balmerdx/BalmerDX_VNA/doc/wiki_img/history/vna_v1.JPG

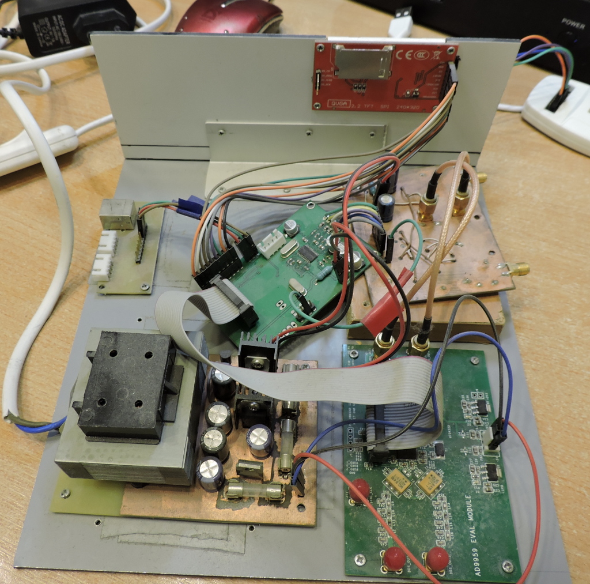
doc/wiki_img/history/vna_v1.JPG
