balmerdx/BalmerDX_VNA/doc/wiki_img/device/calibraion_menu.JPG

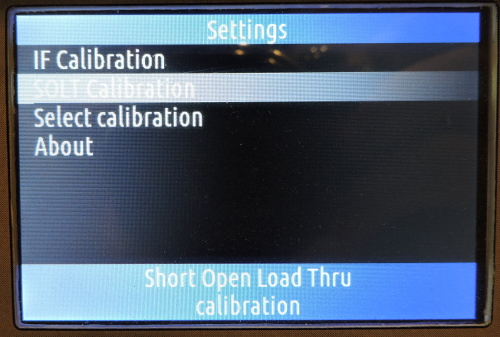
doc/wiki_img/device/calibraion_menu.JPG
