balmerdx/BalmerDX_VNA/README.md

# BalmerDX_VNA
Vector Network Analyzer 10 KHz - 180 MHz

[See Wiki documentation for details](https://github.com/balmerdx/BalmerDX_VNA/wiki)
