balmerdx/BalmerDX_VNA/info_stable.txt

- IDC-8 самый короткий шлейф с аналоговым сигналом 8 см
- IDC-8 шлейф на AD9958 пусть будет 10 см
- IDC-10 шлейф на энкодеры 15 см

- из модуля Step-Down MP1584 выпаиваем переменный резистор,
  и запаиваем резистор 27 КОм на специально предусмотренное для этого место
  на выходе будет 3.4 V

 - сначала сделать IF Calibration
 	определяет тоно частоту промежуточной частоты которая должна быть 1000 Гц

 - SOLT calibration
 	Все калибровки делаются с щупами, с которыми будут происходить измерения. Цупы должны быть коаксиальным кабелем с волновым сопротивлением 50 Ом.
 	s - short Нужно закоротить накоротко RX выход.
 	o - open Оставить RX выход открытым.
 	l - load
 	t - through
