balmerdx/BalmerDX_VNA/circuit_kicad/info/HTB1NCwRLpXXXXaKaXXXq6xXFXXXn.jpg

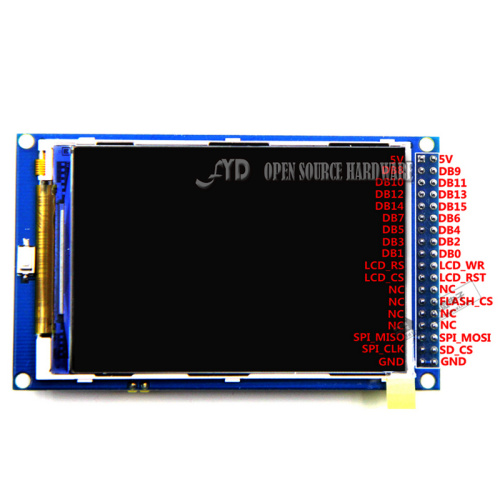
circuit_kicad/info/HTB1NCwRLpXXXXaKaXXXq6xXFXXXn.jpg
