balmerdx/BalmerDX_VNA/circuit_kicad/info/HTB1714cLFXXXXc.XpXXq6xXFXXXj.jpg

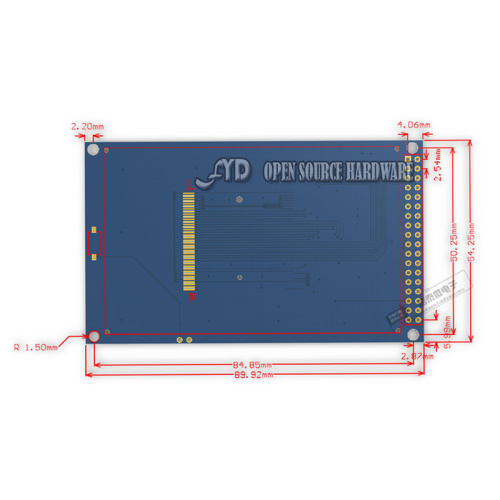
circuit_kicad/info/HTB1714cLFXXXXc.XpXXq6xXFXXXj.jpg
