balmerdx/BalmerDX_VNA/circuit_kicad/info/SG053-SZ(mil).jpg

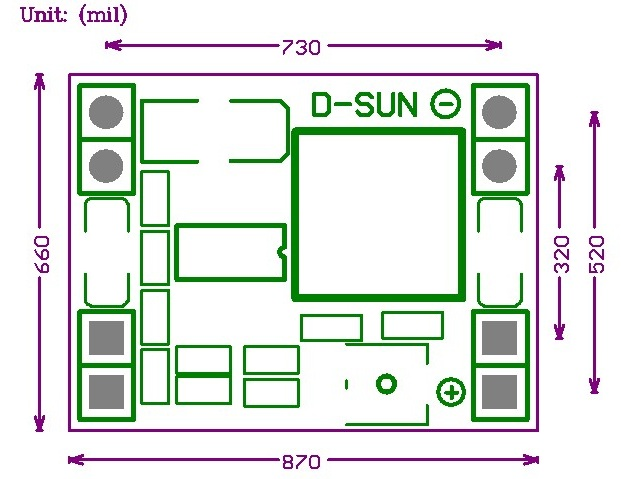
circuit_kicad/info/SG053-SZ(mil).jpg
