balmerdx/BalmerDX_VNA/circuit_kicad/info/SG053-SZ(mm).jpg

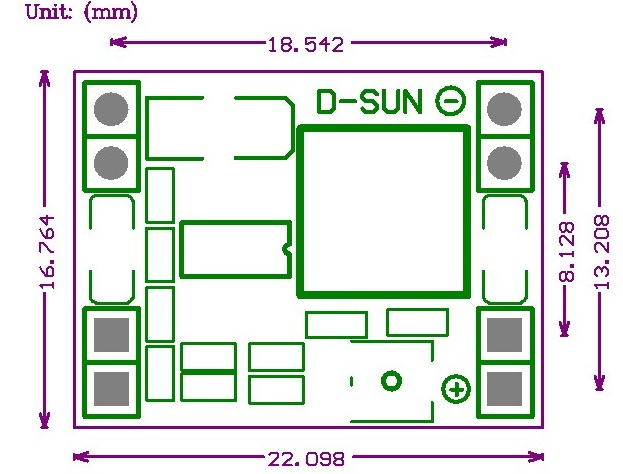
circuit_kicad/info/SG053-SZ(mm).jpg
