balmerdx/BalmerDX_VNA/doc/wiki_img/device/graph.JPG

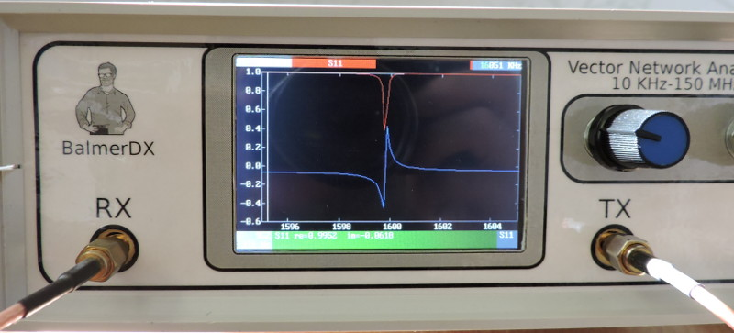
doc/wiki_img/device/graph.JPG
