balmerdx/BalmerDX_VNA/doc/wiki_img/device/main_menu.JPG

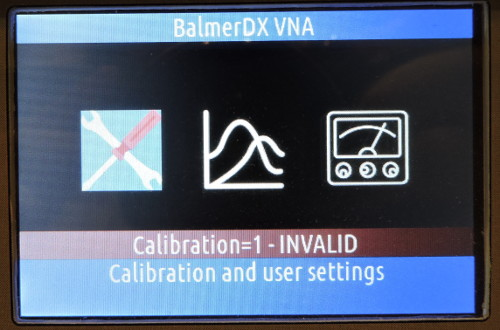
doc/wiki_img/device/main_menu.JPG
