balmerdx/BalmerDX_VNA/doc/wiki_img/device/single_freq.JPG

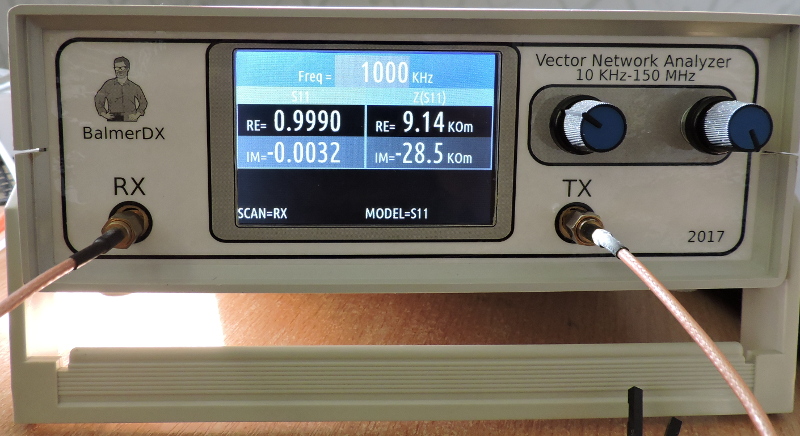
doc/wiki_img/device/single_freq.JPG
