balmerdx/BalmerDX_VNA/doc/wiki_img/frontend/filter10_24MHz_dB(S21).png

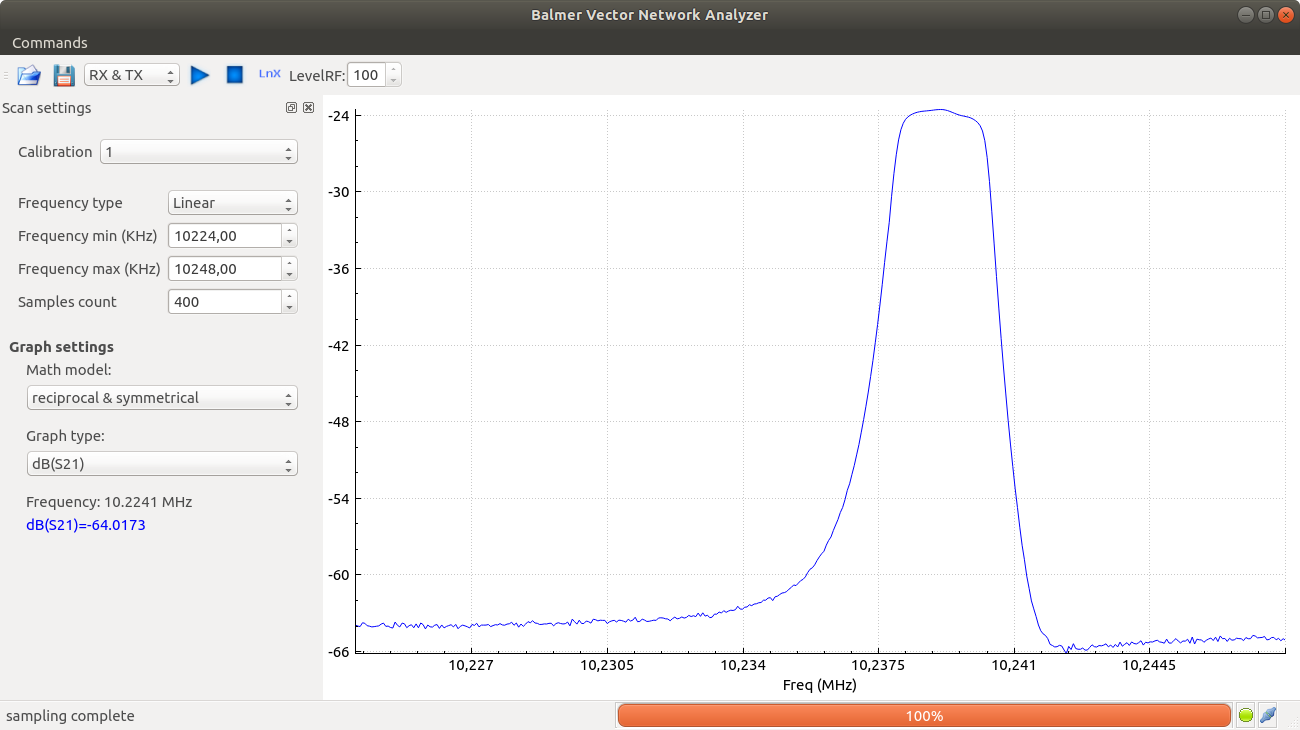
doc/wiki_img/frontend/filter10_24MHz_dB(S21).png
