balmerdx/BalmerDX_VNA/doc/wiki_img/frontend/filter10_24MHz_S21.png

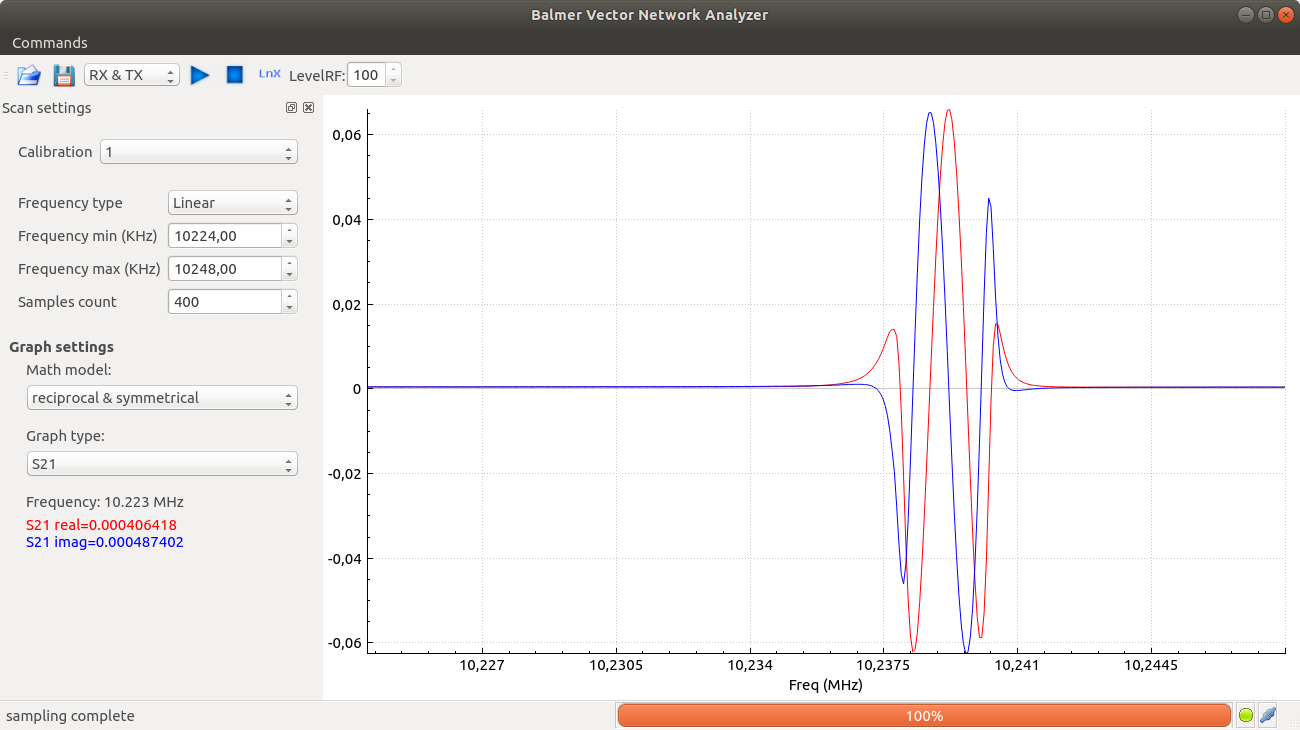
doc/wiki_img/frontend/filter10_24MHz_S21.png
