balmerdx/BalmerDX_VNA/doc/wiki_img/frontend/inductance_100uH_S11.png

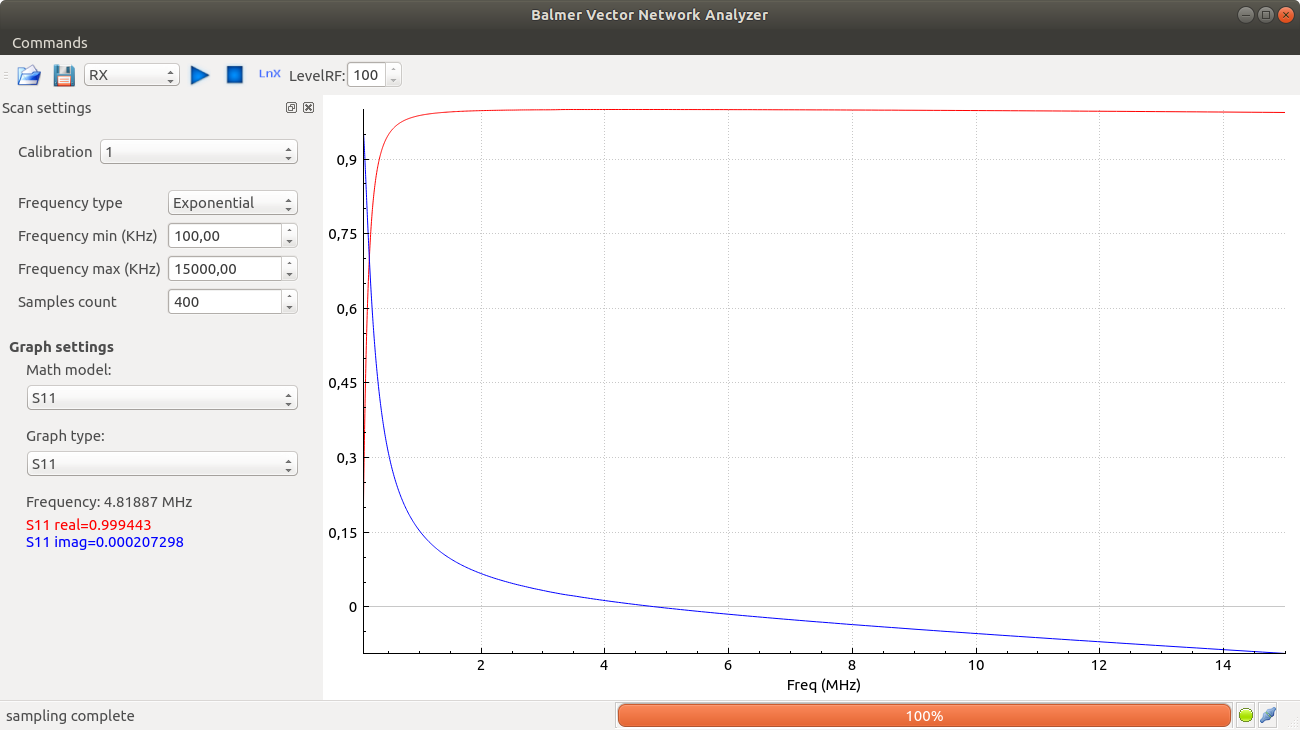
doc/wiki_img/frontend/inductance_100uH_S11.png
