balmerdx/BalmerDX_VNA/doc/wiki_img/frontend/inductance_100uH_Z(S11).png

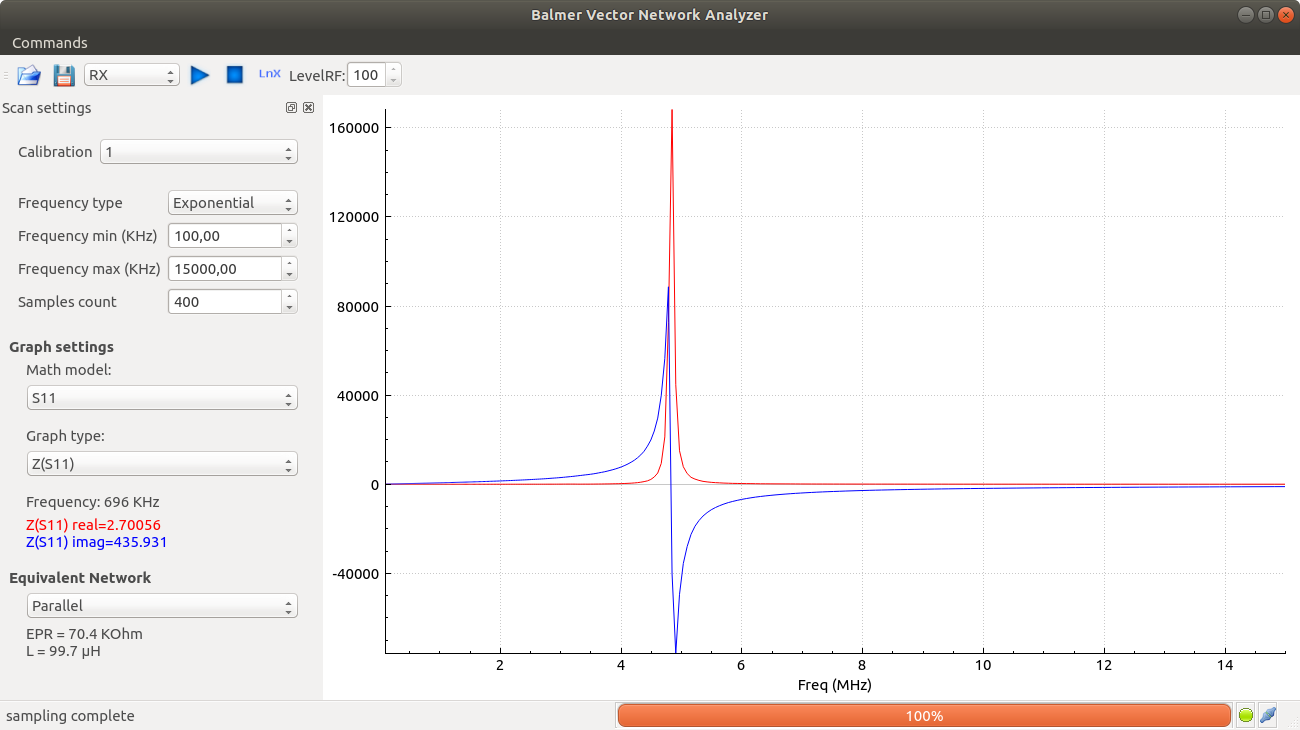
doc/wiki_img/frontend/inductance_100uH_Z(S11).png
