balmerdx/BalmerDX_VNA/doc/wiki_img/frontend/quartz16mhz_S21.png

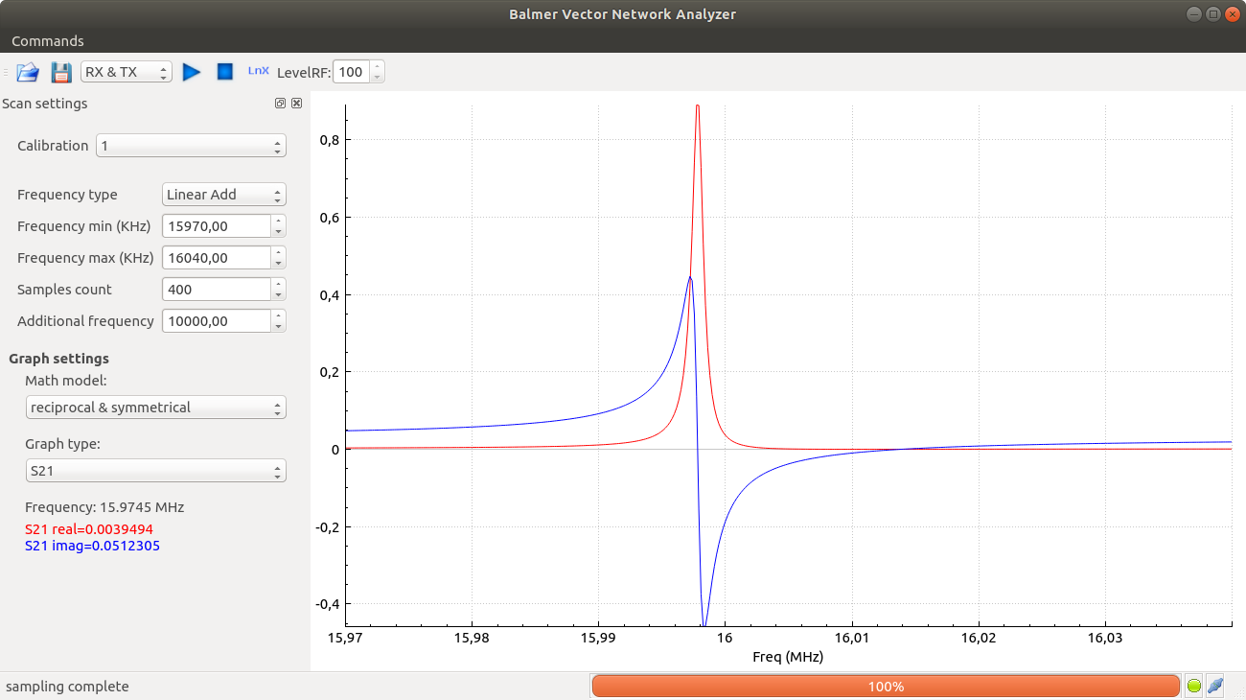
doc/wiki_img/frontend/quartz16mhz_S21.png
