balmerdx/BalmerDX_VNA/doc/wiki_img/home/vna_front.JPG

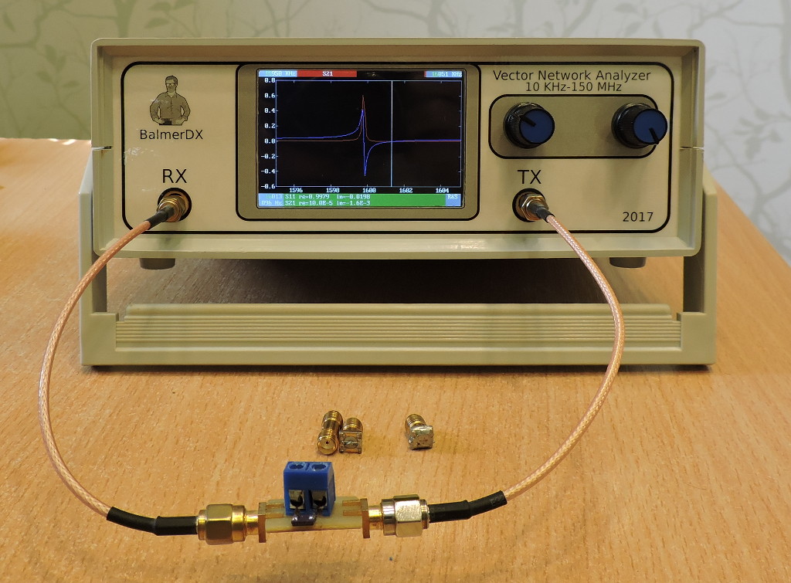
doc/wiki_img/home/vna_front.JPG
