balmerdx/BalmerDX_VNA/doc/wiki_img/misc/MP1584.JPG

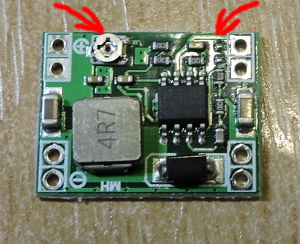
doc/wiki_img/misc/MP1584.JPG
