balmerdx/BalmerDX_VNA/doc/wiki_img/schematic/board_sch1_back.JPG

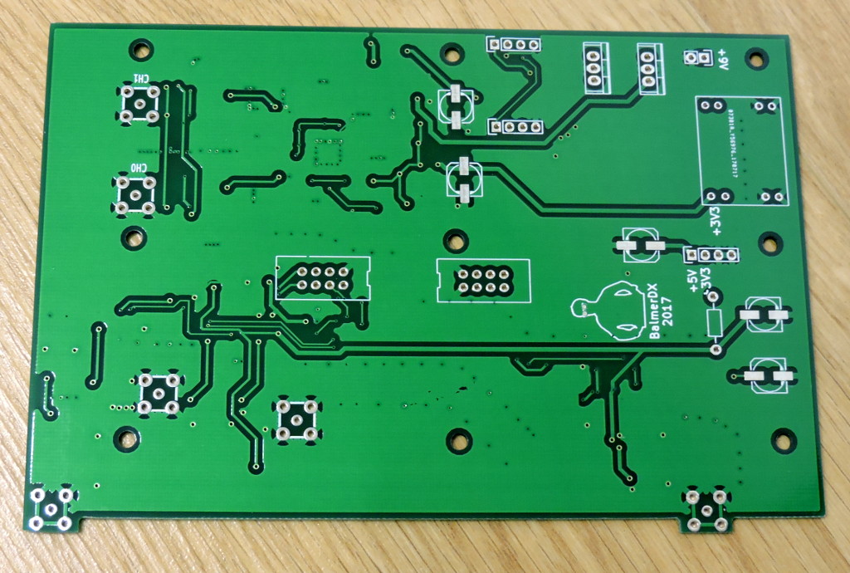
doc/wiki_img/schematic/board_sch1_back.JPG
