balmerdx/BalmerDX_VNA/doc/wiki_img/schematic/board_sch1_front.JPG

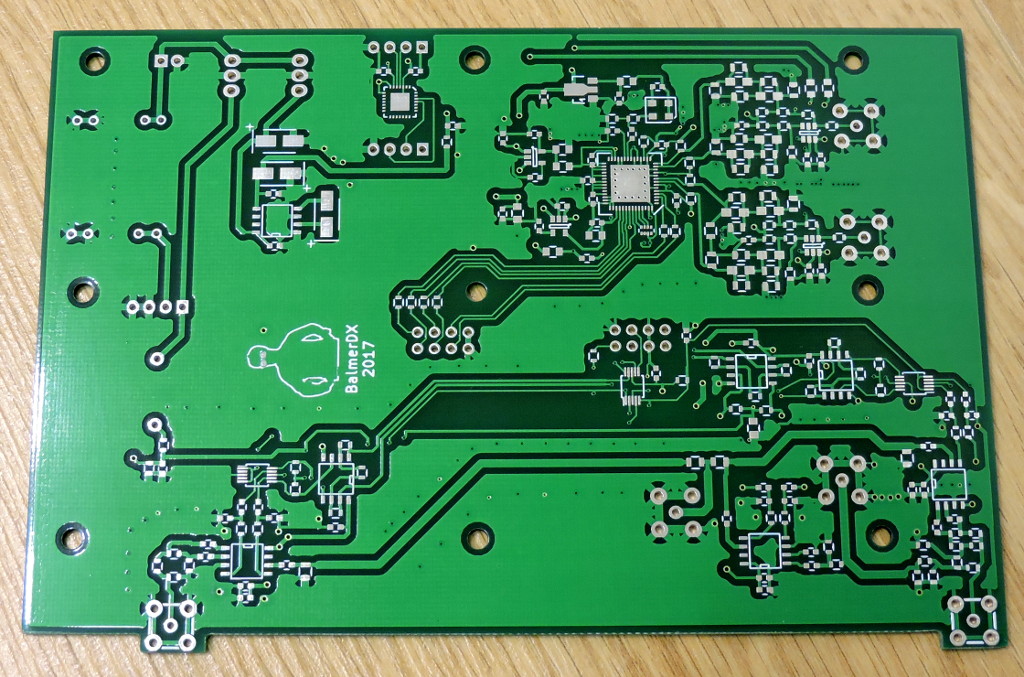
doc/wiki_img/schematic/board_sch1_front.JPG
