balmerdx/BalmerDX_VNA/doc/wiki_img/schematic/board_sch2_and_sch3.JPG

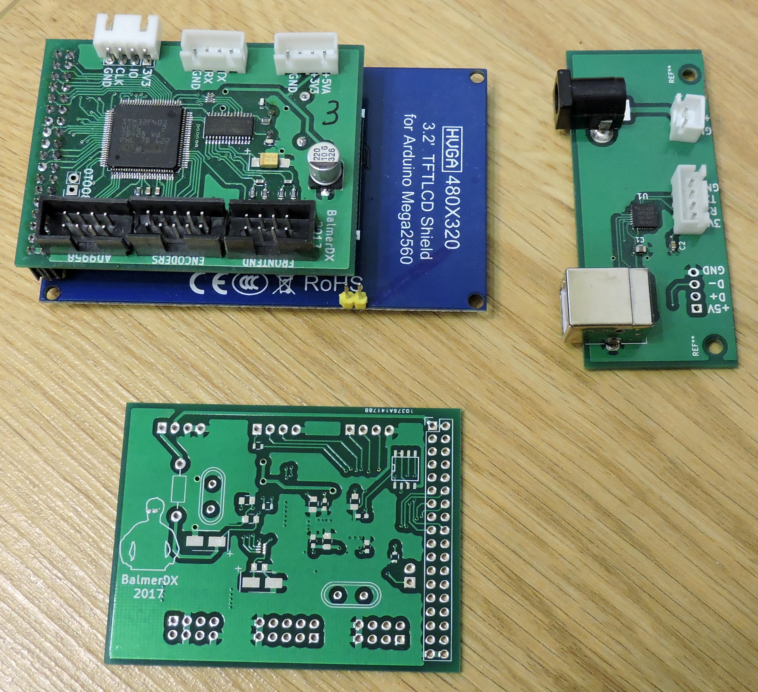
doc/wiki_img/schematic/board_sch2_and_sch3.JPG
