balmerdx/BalmerDX_VNA/doc/wiki_img/schematic/sch1_ad9958.png

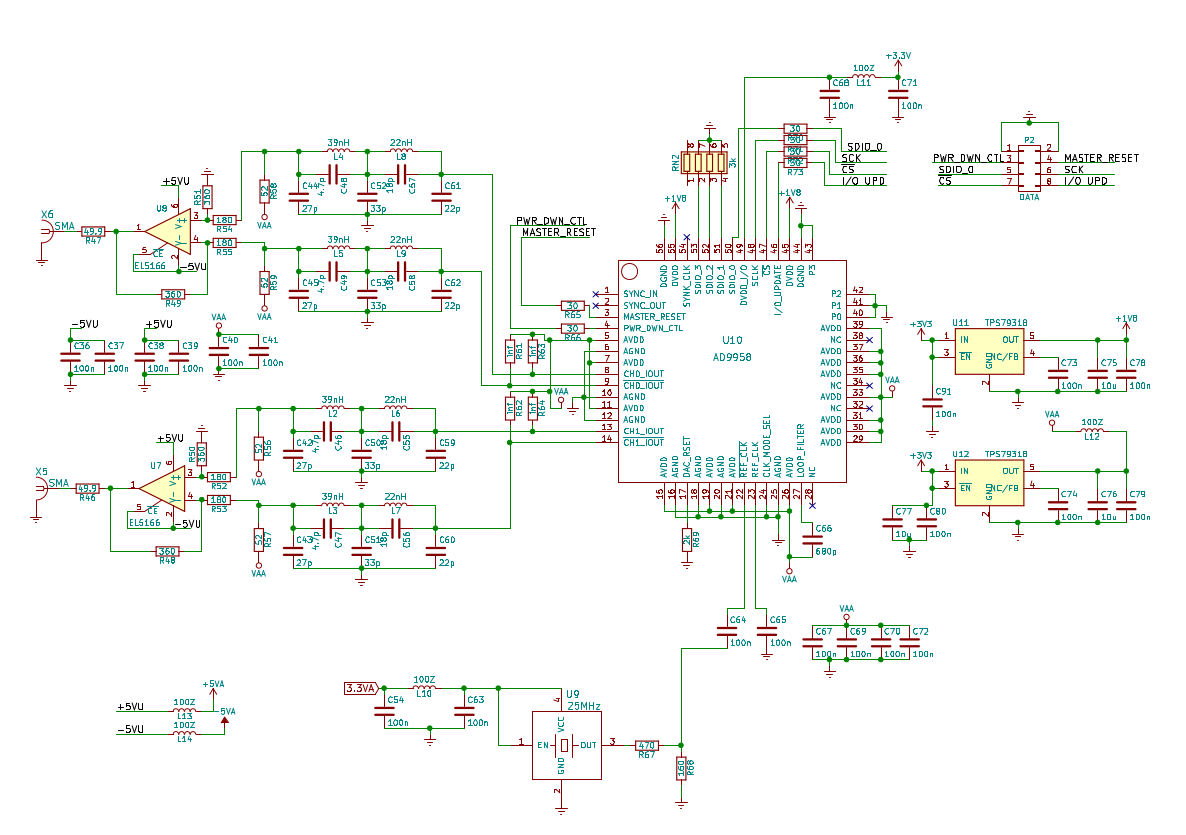
doc/wiki_img/schematic/sch1_ad9958.png
