balmerdx/BalmerDX_VNA/doc/wiki_img/schematic/sch1_analog.png

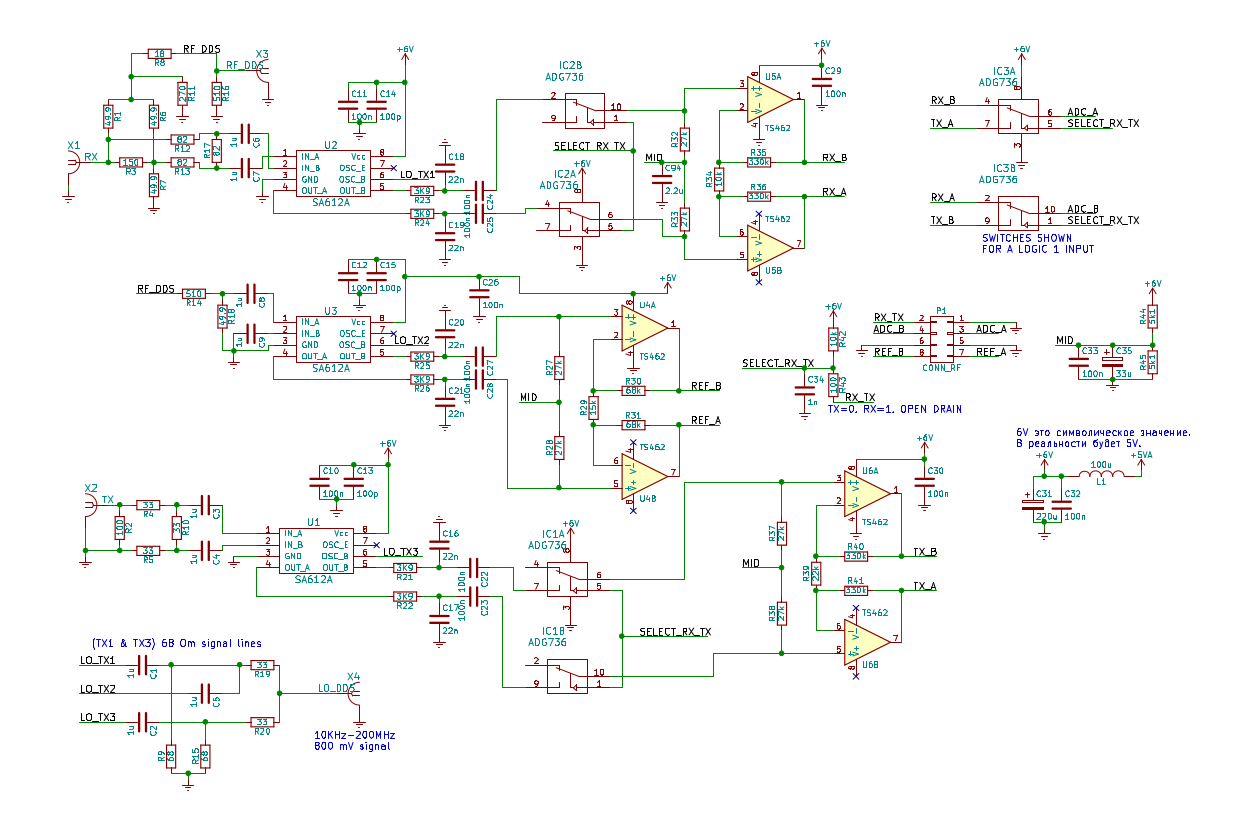
doc/wiki_img/schematic/sch1_analog.png
