balmerdx/BalmerDX_VNA/doc/wiki_img/schematic/sch1_analog_power.png

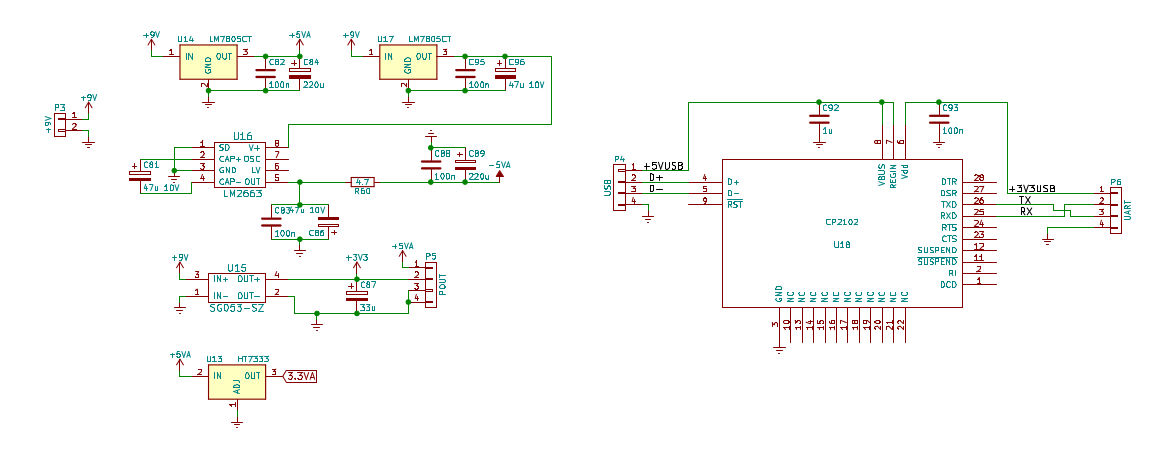
doc/wiki_img/schematic/sch1_analog_power.png
