balmerdx/BalmerDX_VNA/doc/wiki_img/schematic/sch2_cs4272.png

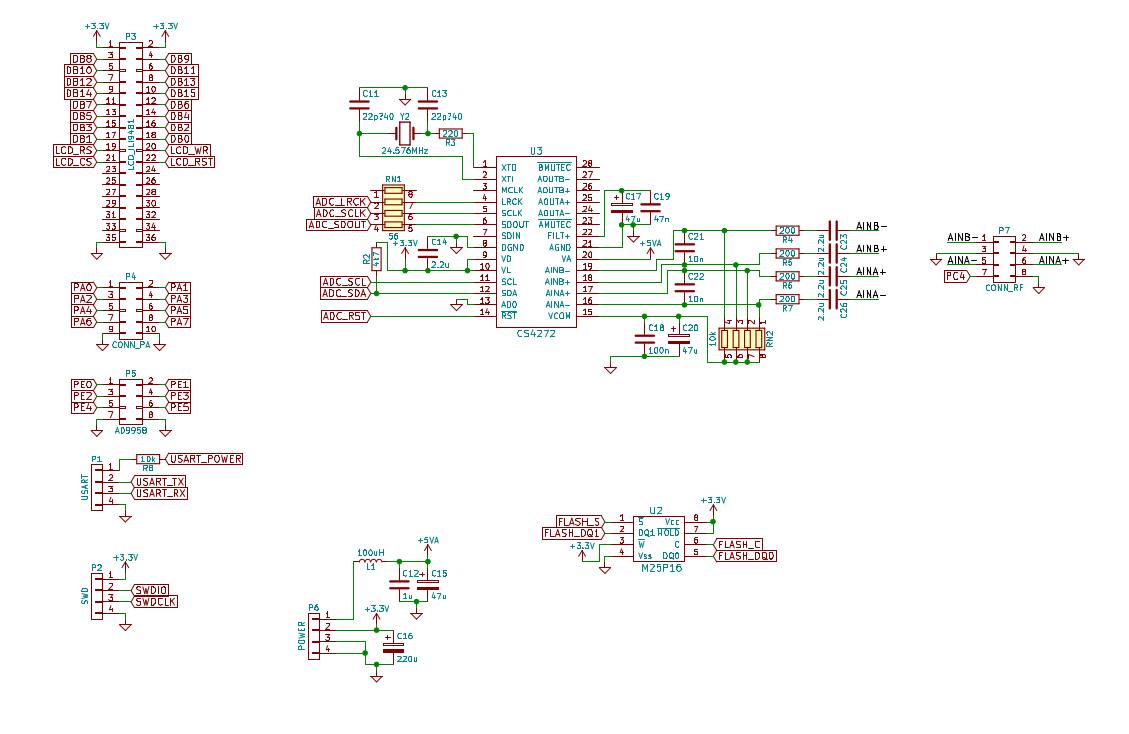
doc/wiki_img/schematic/sch2_cs4272.png
