balmerdx/BalmerDX_VNA/doc/wiki_img/schematic/sch2_STM32F405.png

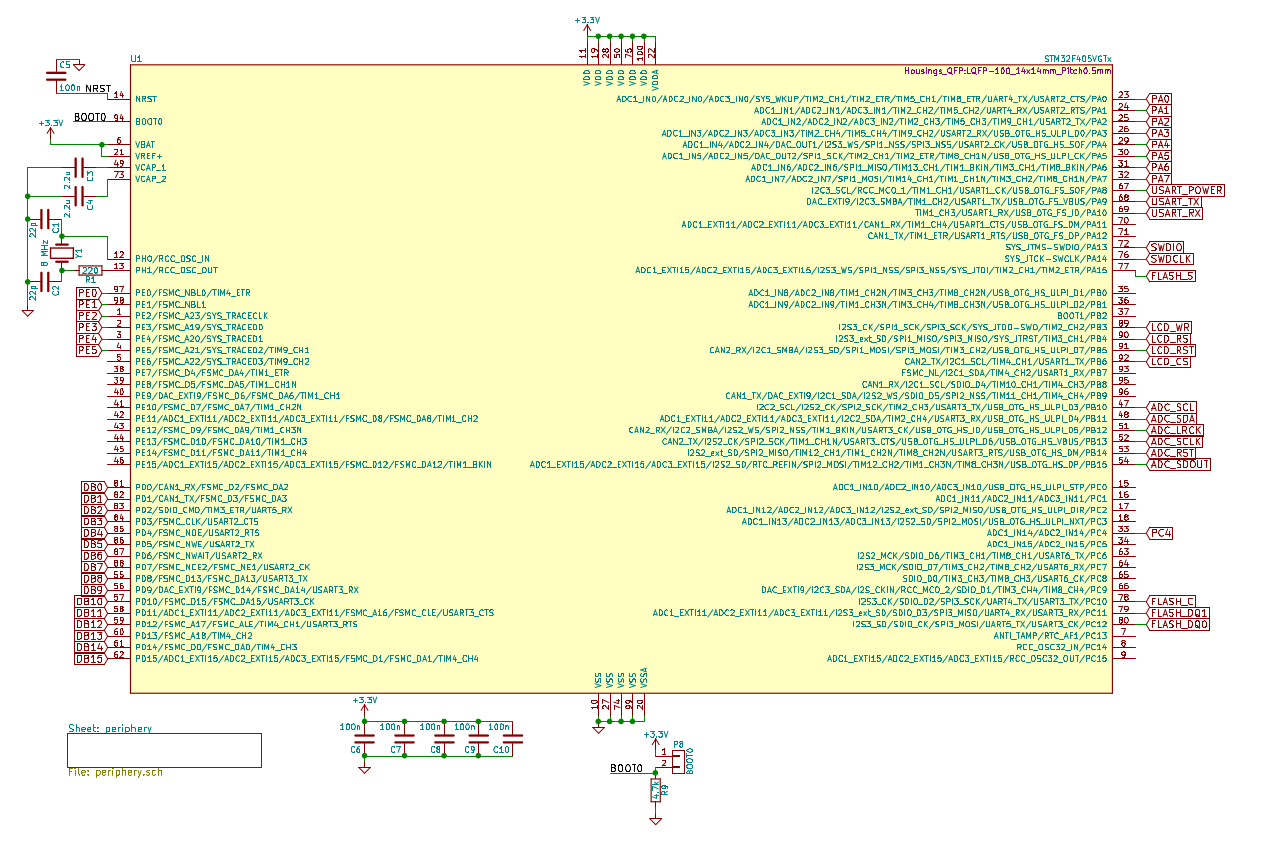
doc/wiki_img/schematic/sch2_STM32F405.png
