balmerdx/BalmerDX_VNA/doc/wiki_img/schematic/sch3_perifery.png

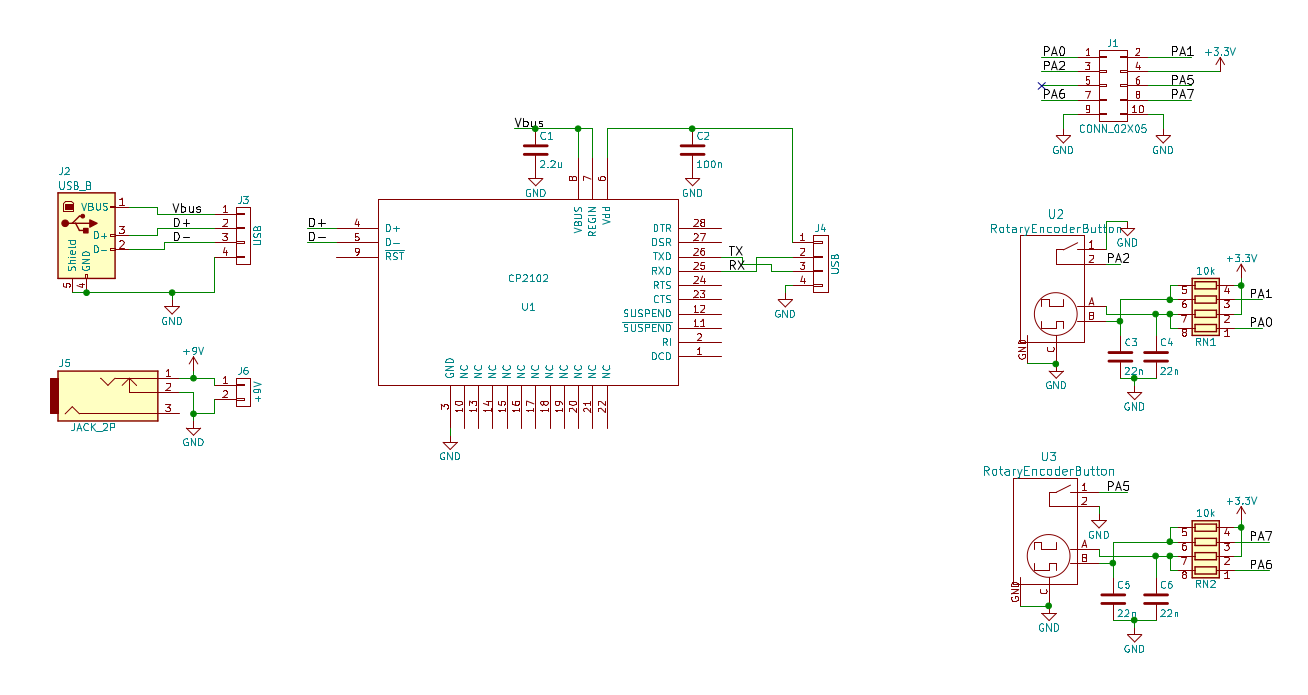
doc/wiki_img/schematic/sch3_perifery.png
