balmerdx/BalmerDX_VNA/frontend/doc/model_rx_parallel.png

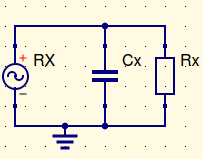
frontend/doc/model_rx_parallel.png
