balmerdx/BalmerDX_VNA/frontend/doc/model_rx_serial.png

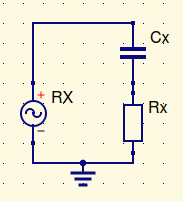
frontend/doc/model_rx_serial.png
