balmerdx/BalmerDX_VNA/frontend/doc/model_rx_tx_z.png

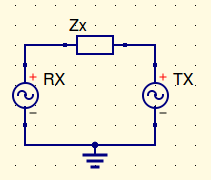
frontend/doc/model_rx_tx_z.png
