balmerdx/BalmerDX_VNA/doc/wiki_img/device/calibration_if.JPG

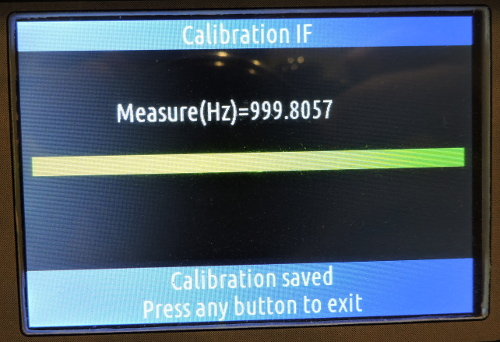
doc/wiki_img/device/calibration_if.JPG
