balmerdx/BalmerDX_VNA/doc/wiki_img/device/SOLT_calibration.JPG

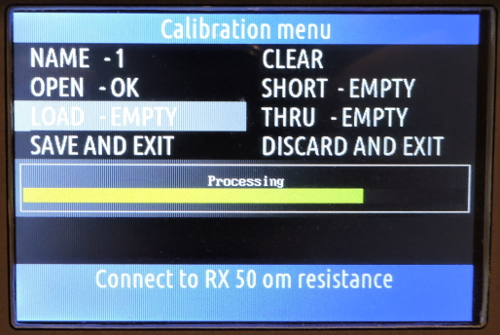
doc/wiki_img/device/SOLT_calibration.JPG
