balmerdx/BalmerDX_VNA/todo.txt

Переделать

/home/balmer/radio/stm32/tools/stm32_flash.py на прямой вызов openocd

- Собрать прошивку в которой одновременно есть и bootloader и векторный анализатор --ok
0x08000000 - 32 кб bootloader
0x08000000 - 32 кб данные всякие мелкие
0x08010000 - 1 кб - размер программы (4 байта) и md5 hash 
0x08010400 - собственно сама программа

- Переделать заливку --ок
	Заливать напрямую bin файл, считая md5 в frontend --ok
	Заливать вариант с bootloader --ok

- залить на github

- писать документацию и статью
