balmerdx/BalmerDX_VNA/doc/wiki_img/history/summary_vna.JPG

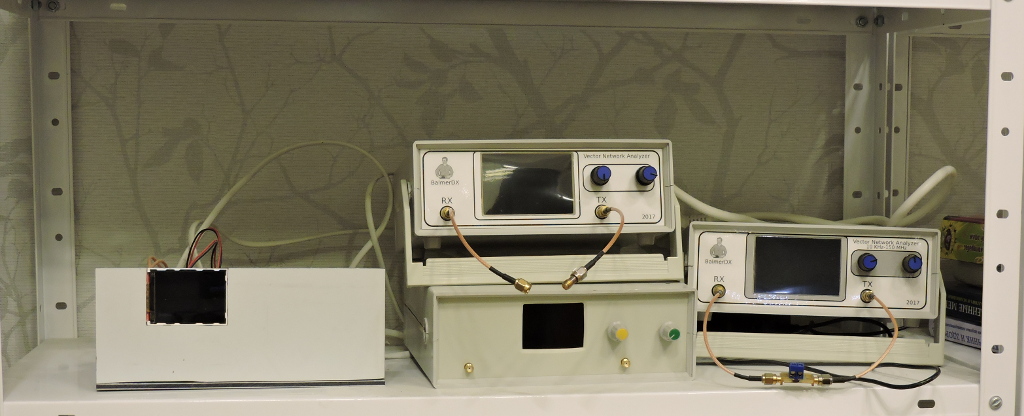
doc/wiki_img/history/summary_vna.JPG
