balmerdx/BalmerDX_VNA/doc/wiki_img/history/vna_v2.JPG

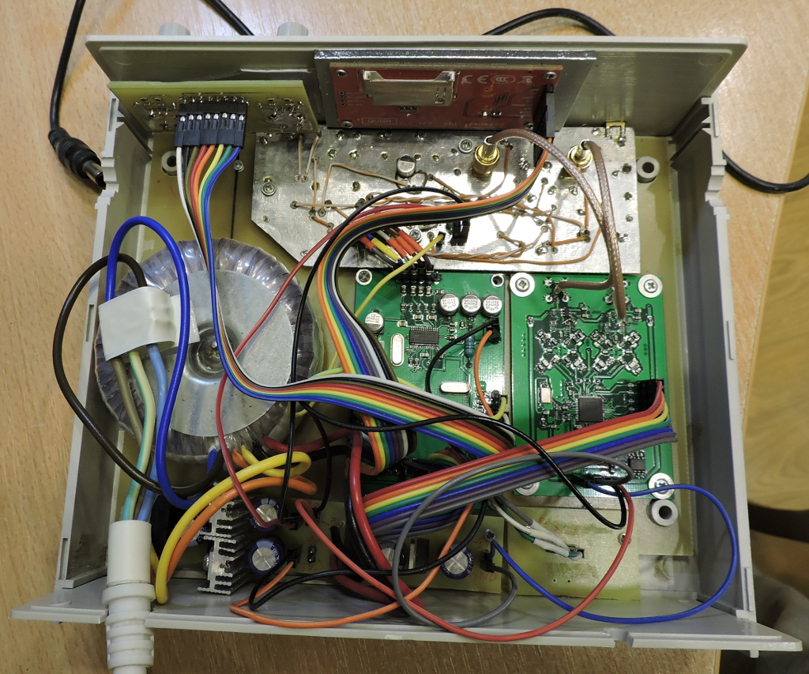
doc/wiki_img/history/vna_v2.JPG
