balmerdx/BalmerDX_VNA/doc/wiki_img/history/vna_v3_1.JPG

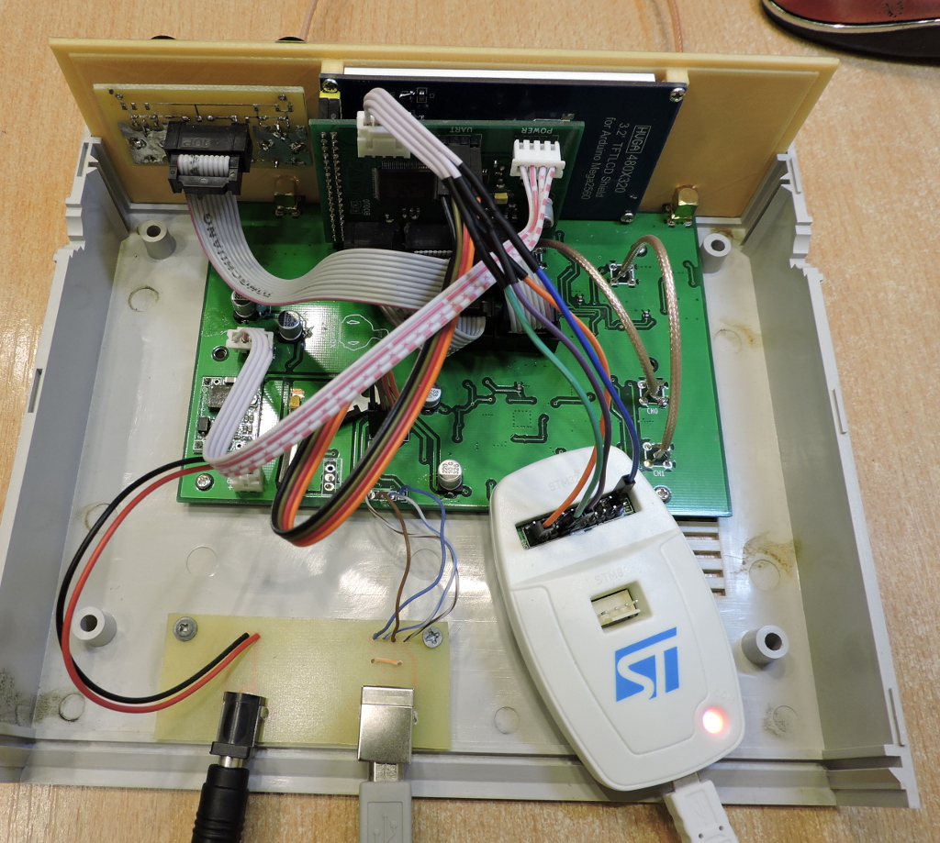
doc/wiki_img/history/vna_v3_1.JPG
