balmerdx/BalmerDX_VNA/doc/wiki_img/history/vna_v3_2.JPG

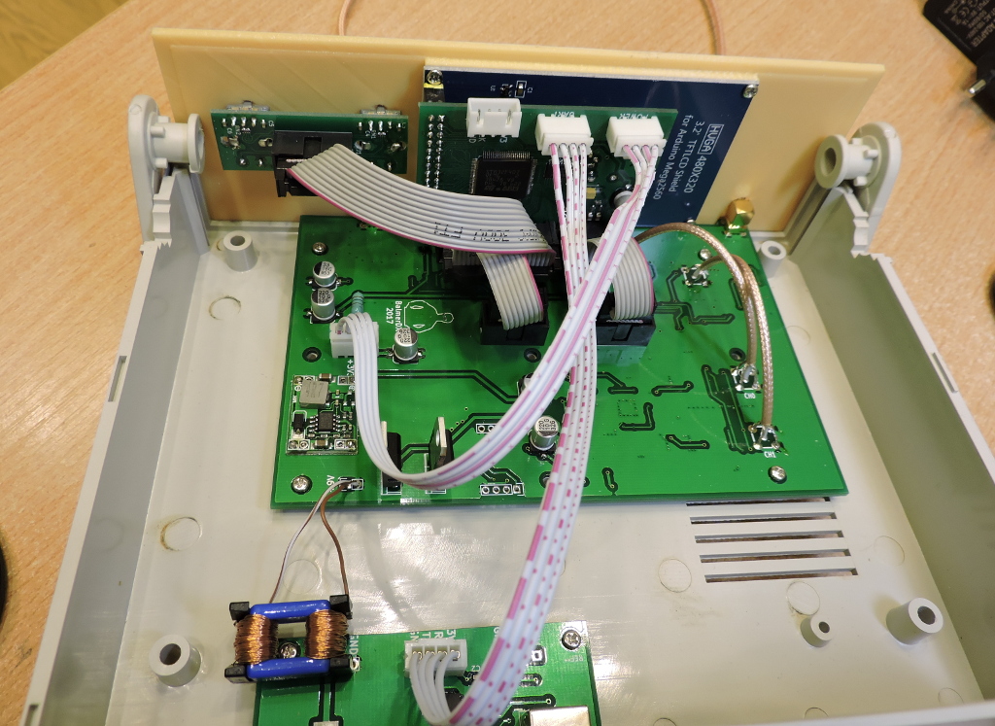
doc/wiki_img/history/vna_v3_2.JPG
