balmerdx/BalmerDX_VNA/doc/wiki_img/schematic/analog_and_ad9958.pdf

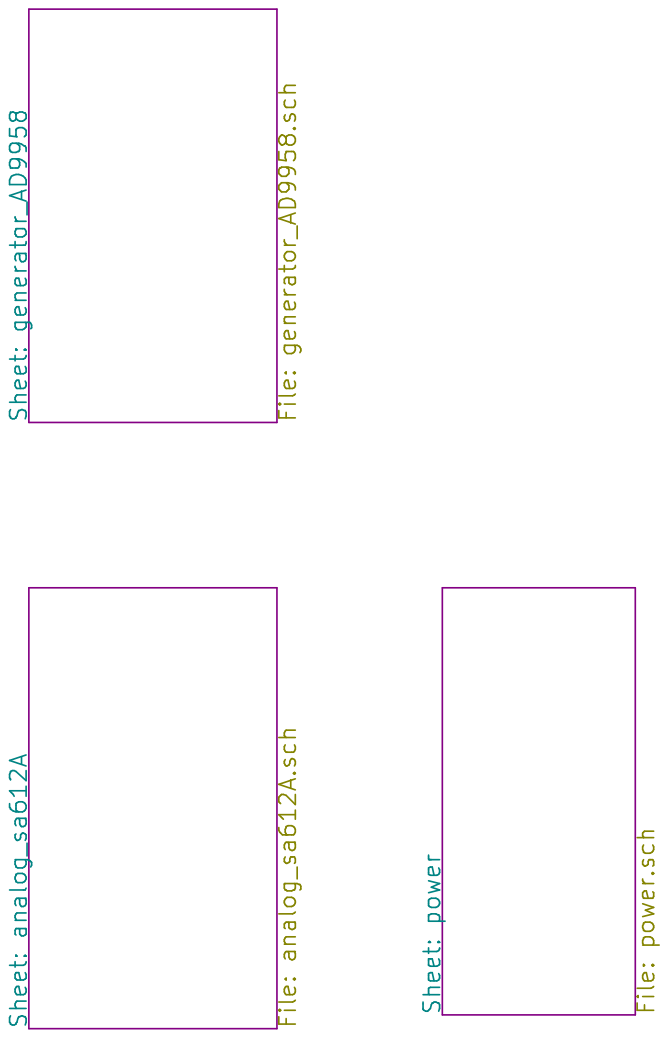
[picture p38: page 1]

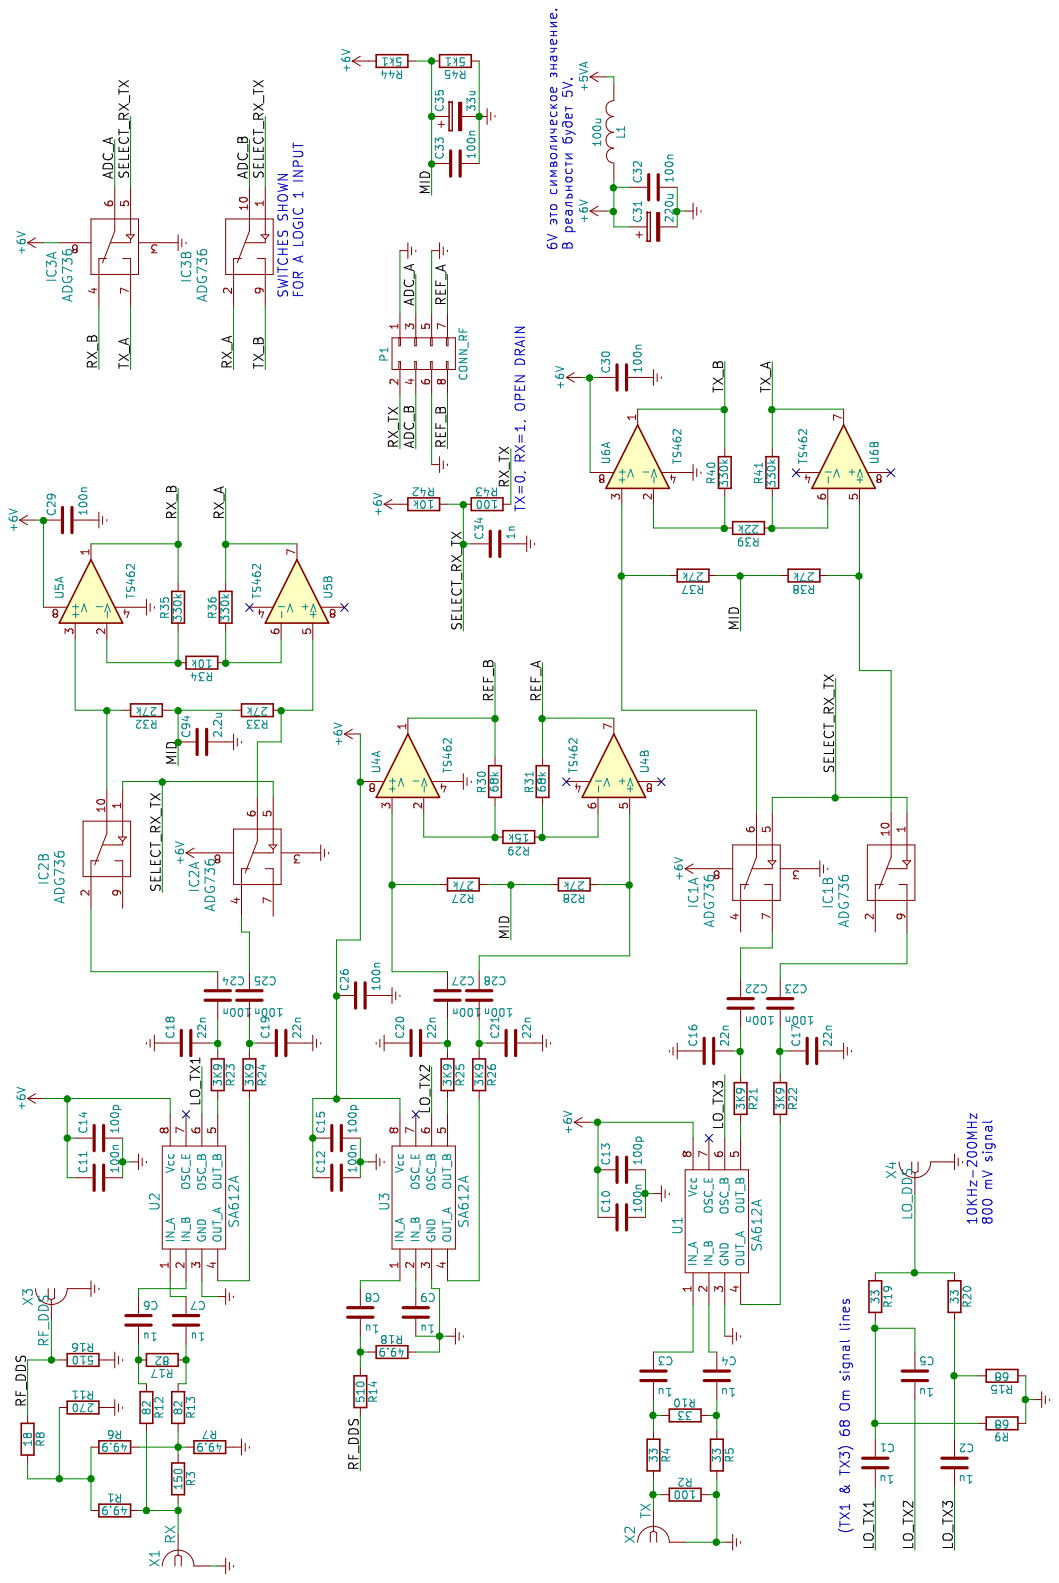
[picture p39: page 2]

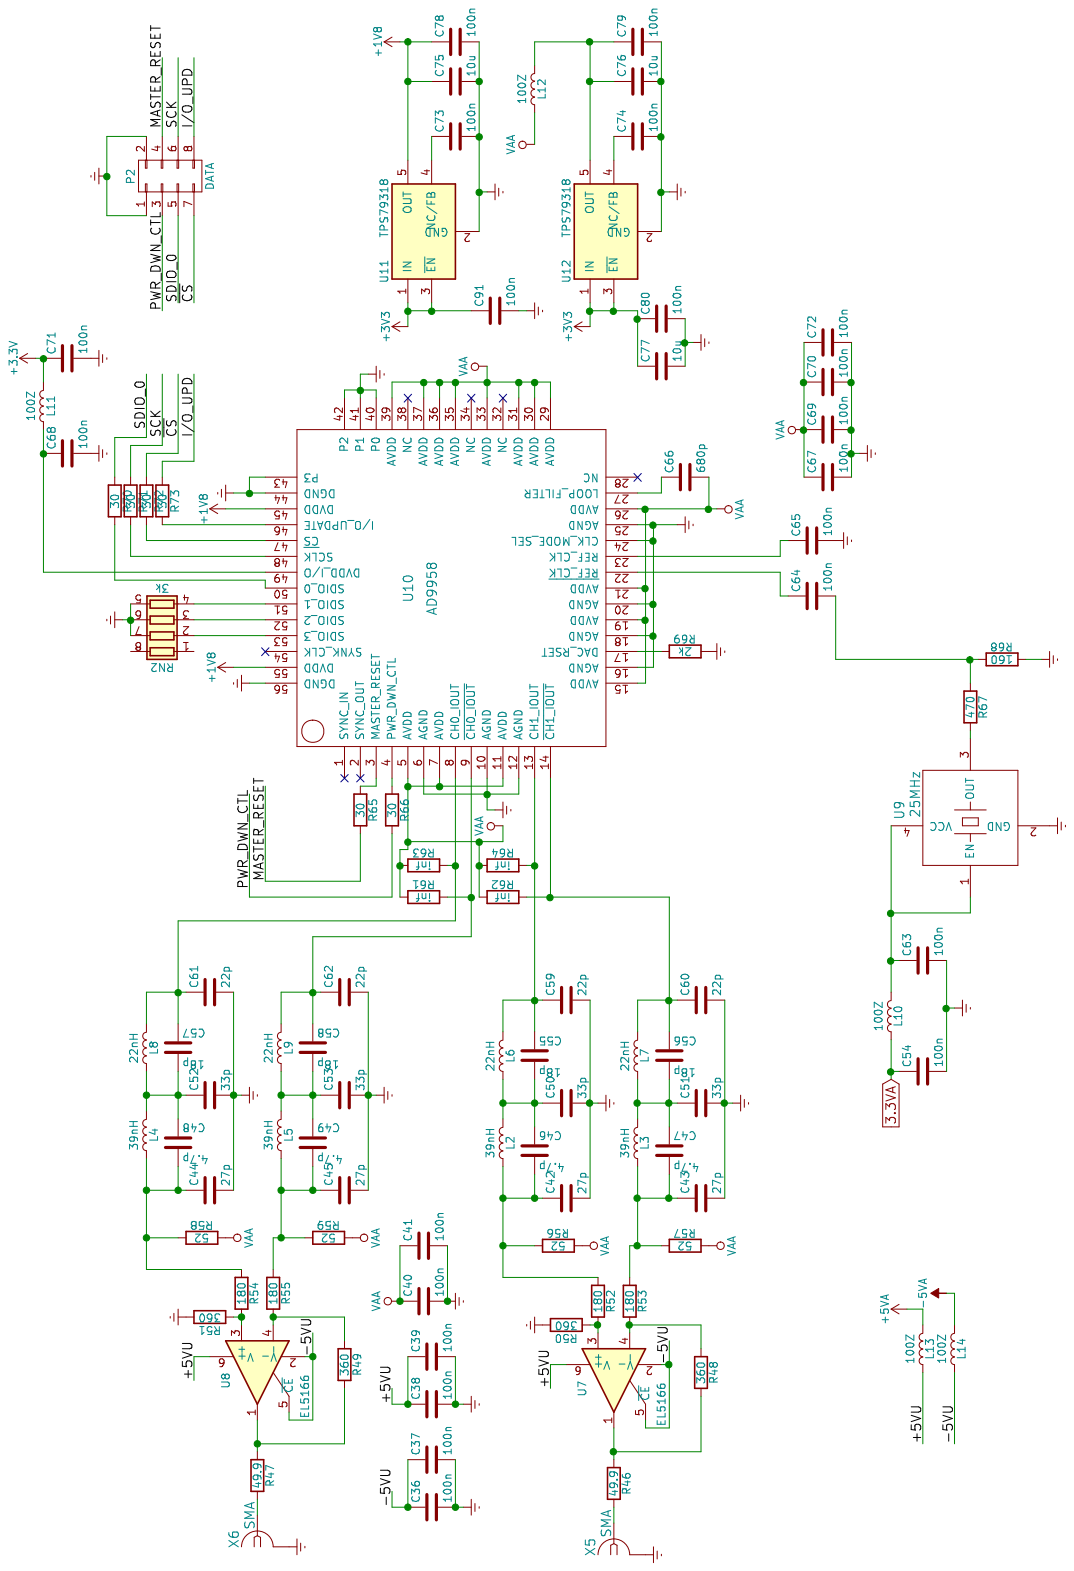
[picture p40: page 3]

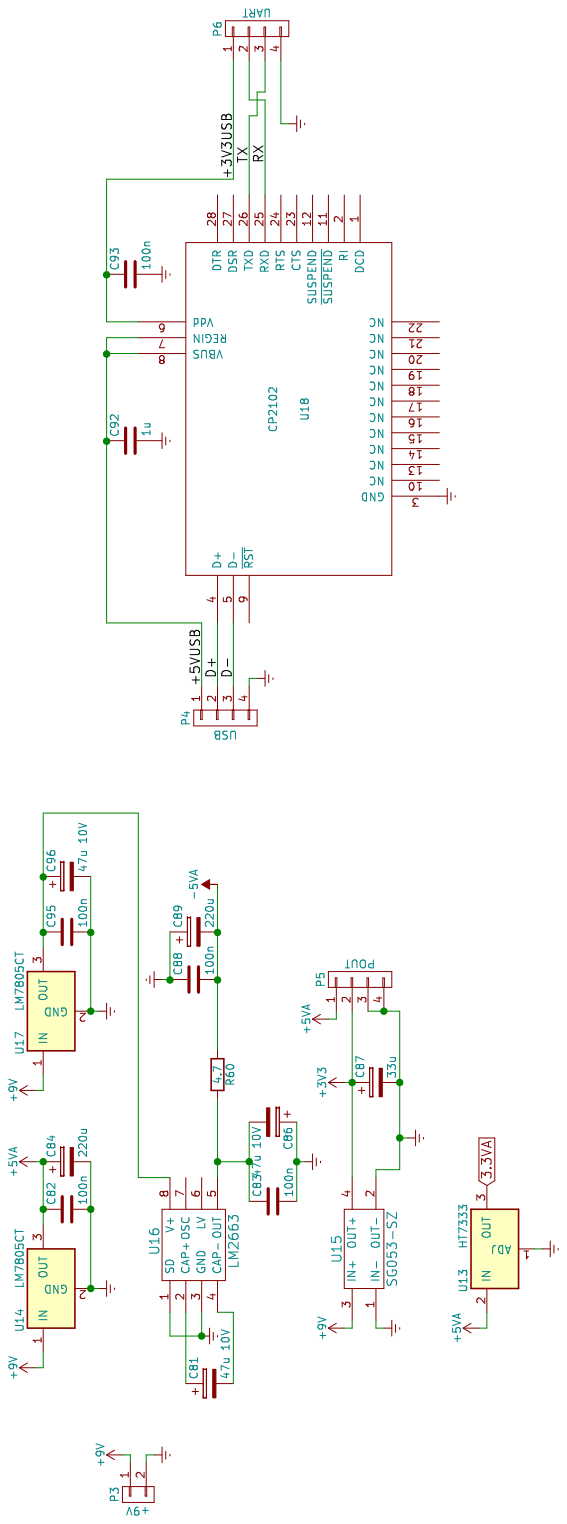
[picture p41: page 4]
