balmerdx/BalmerDX_VNA/doc/wiki_img/schematic/digital_and_adc.pdf

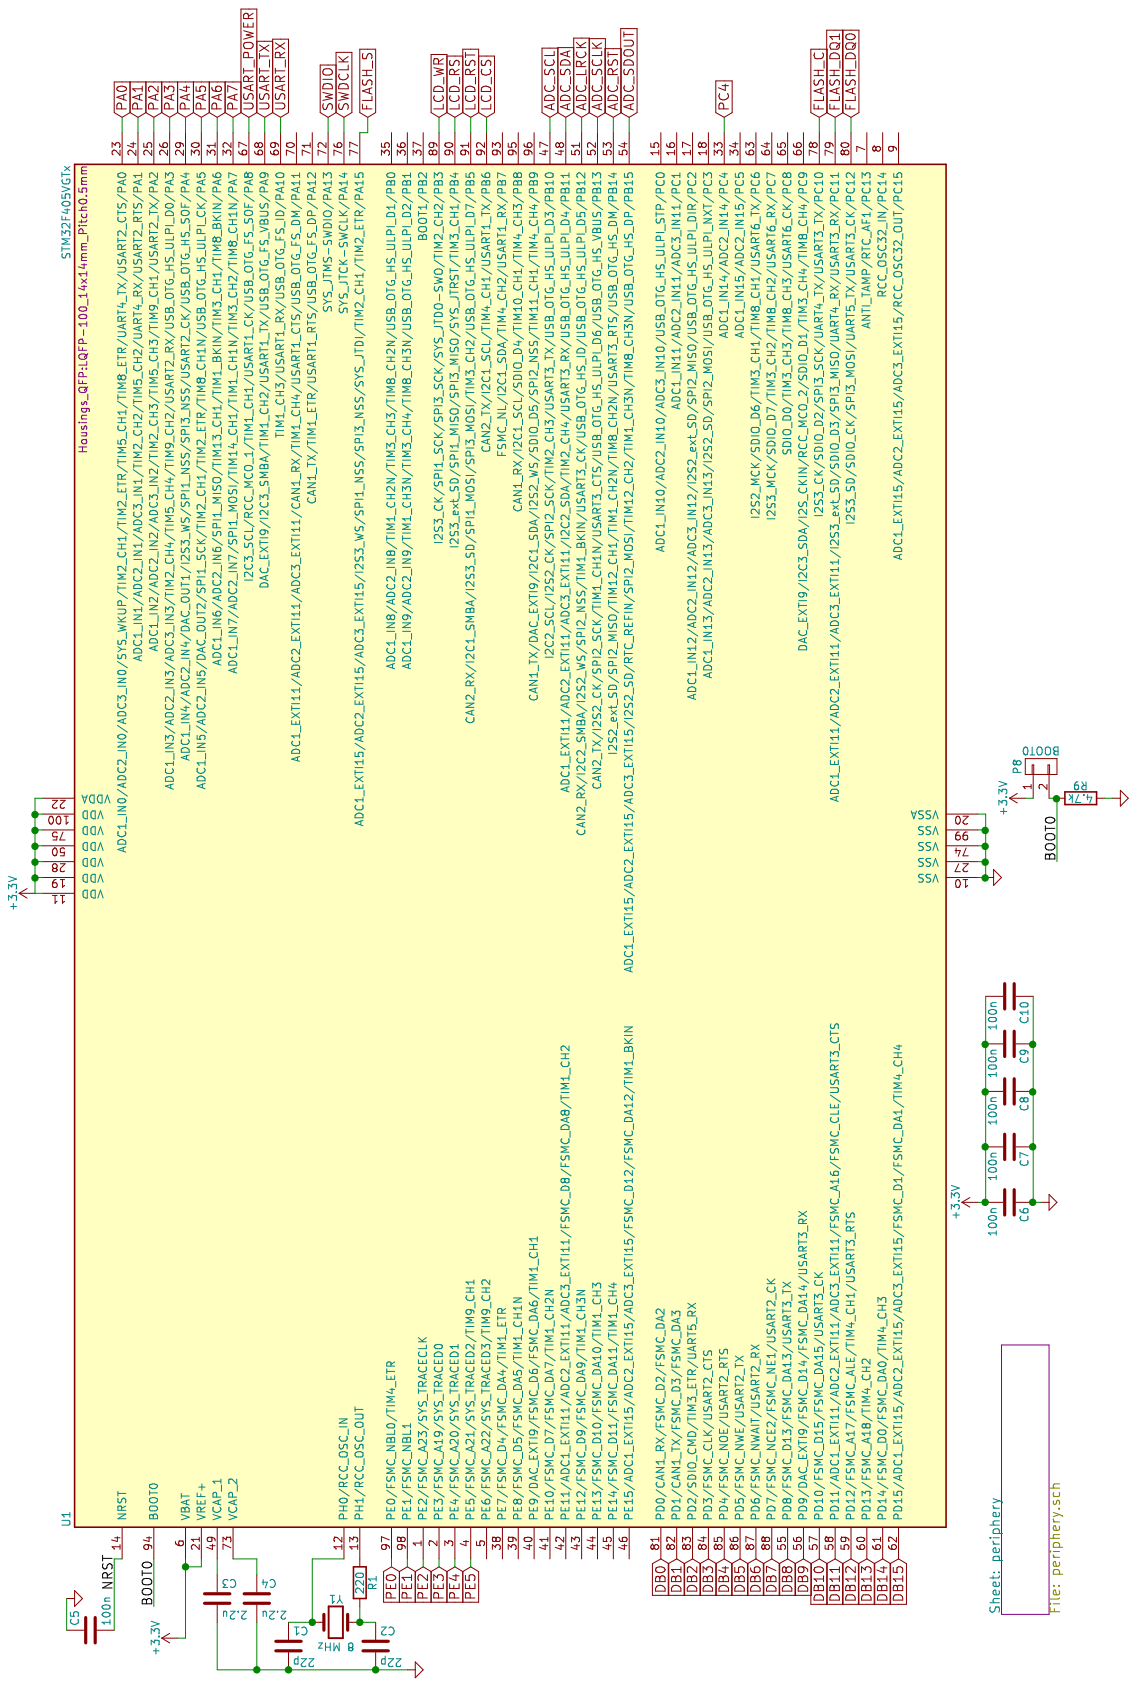
[picture p42: page 1]

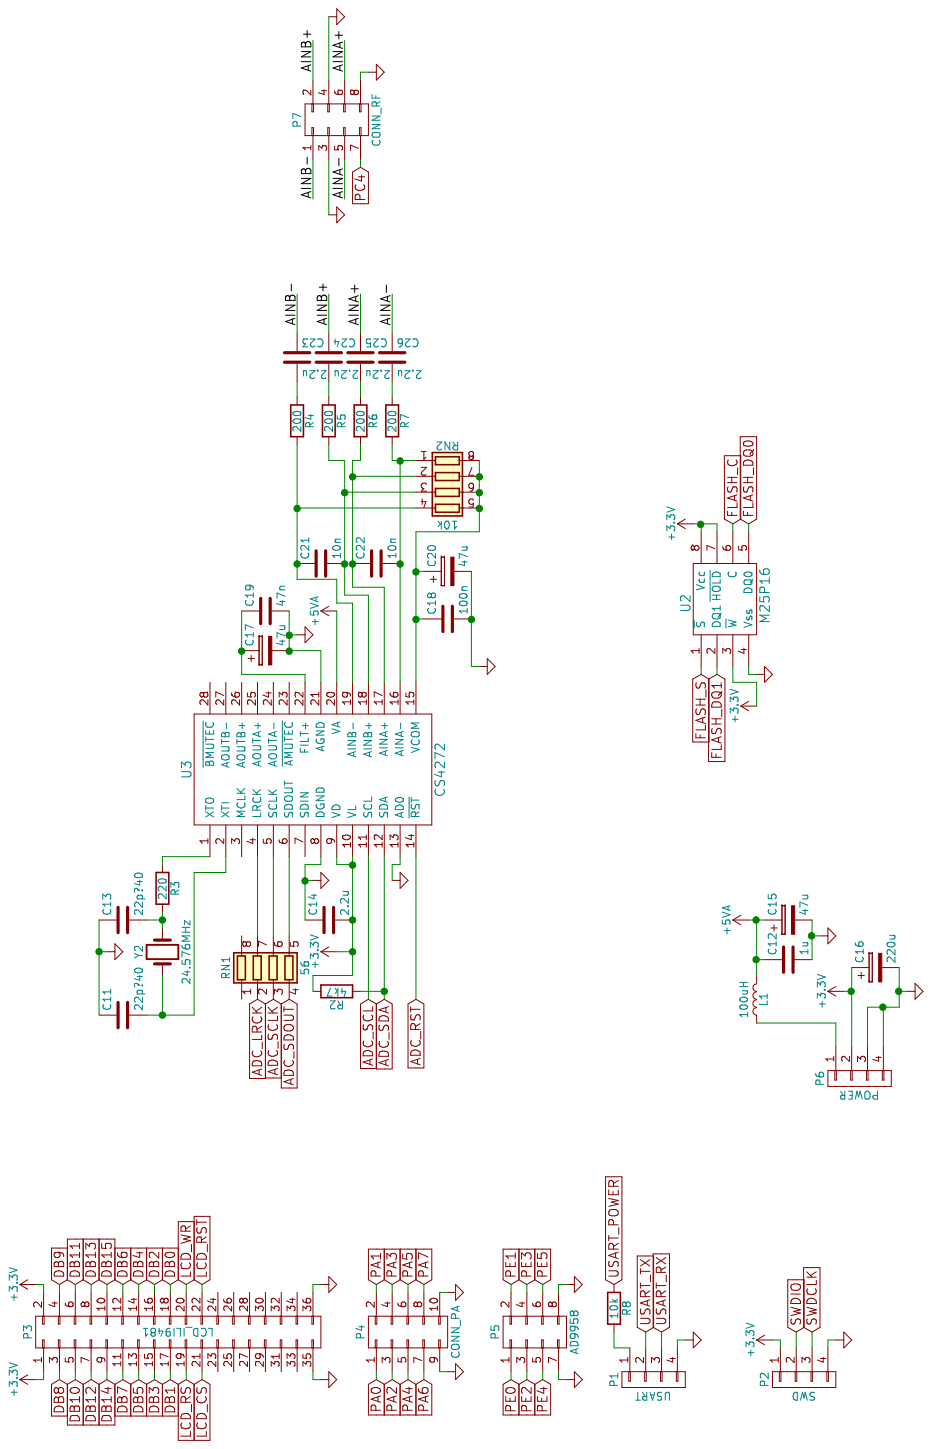
[picture p43: page 2]
