balmerdx/BalmerDX_VNA/doc/wiki_img/schematic/rot_enc_and_power.pdf

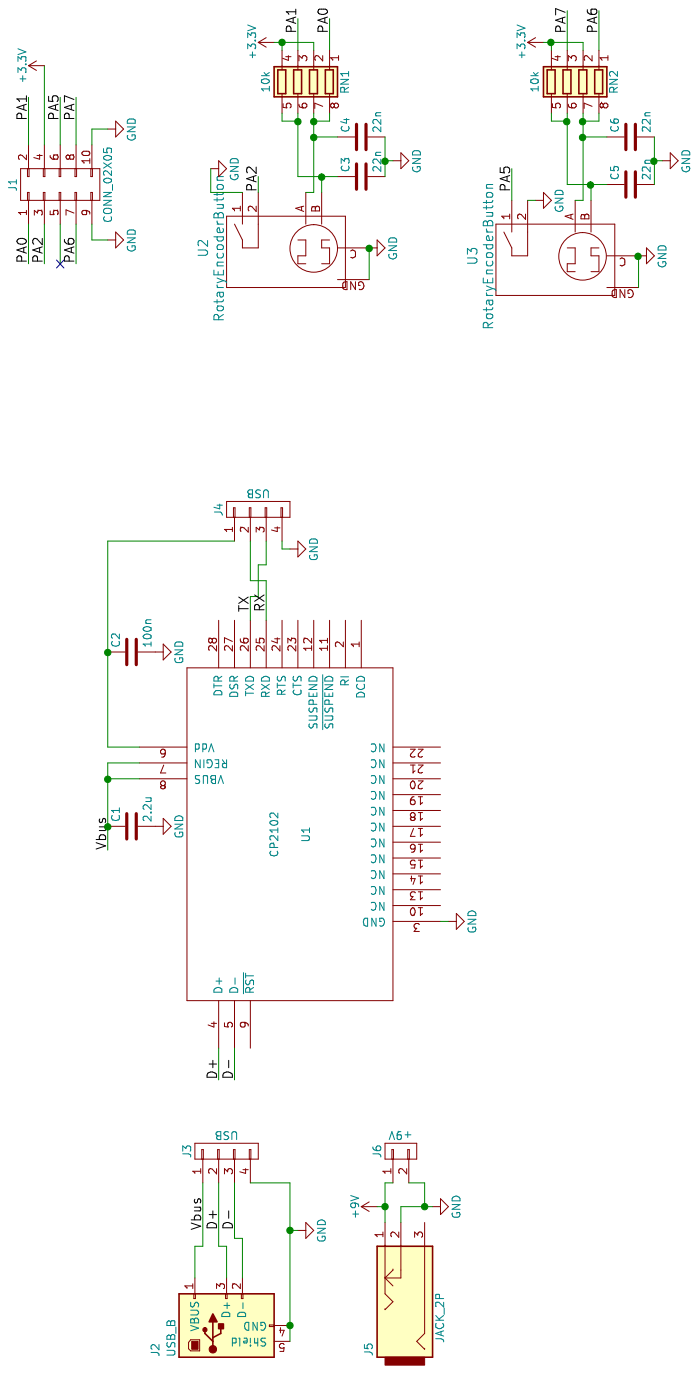
[picture p44: page 1]
