balmerdx/BalmerDX_VNA/circuit_kicad/rot_enc_and_power/rot_enc_and_power.kicad_pcb

## KiCad design circuit_kicad/rot_enc_and_power/rot_enc_and_power.kicad_pcb (2018-08-30)

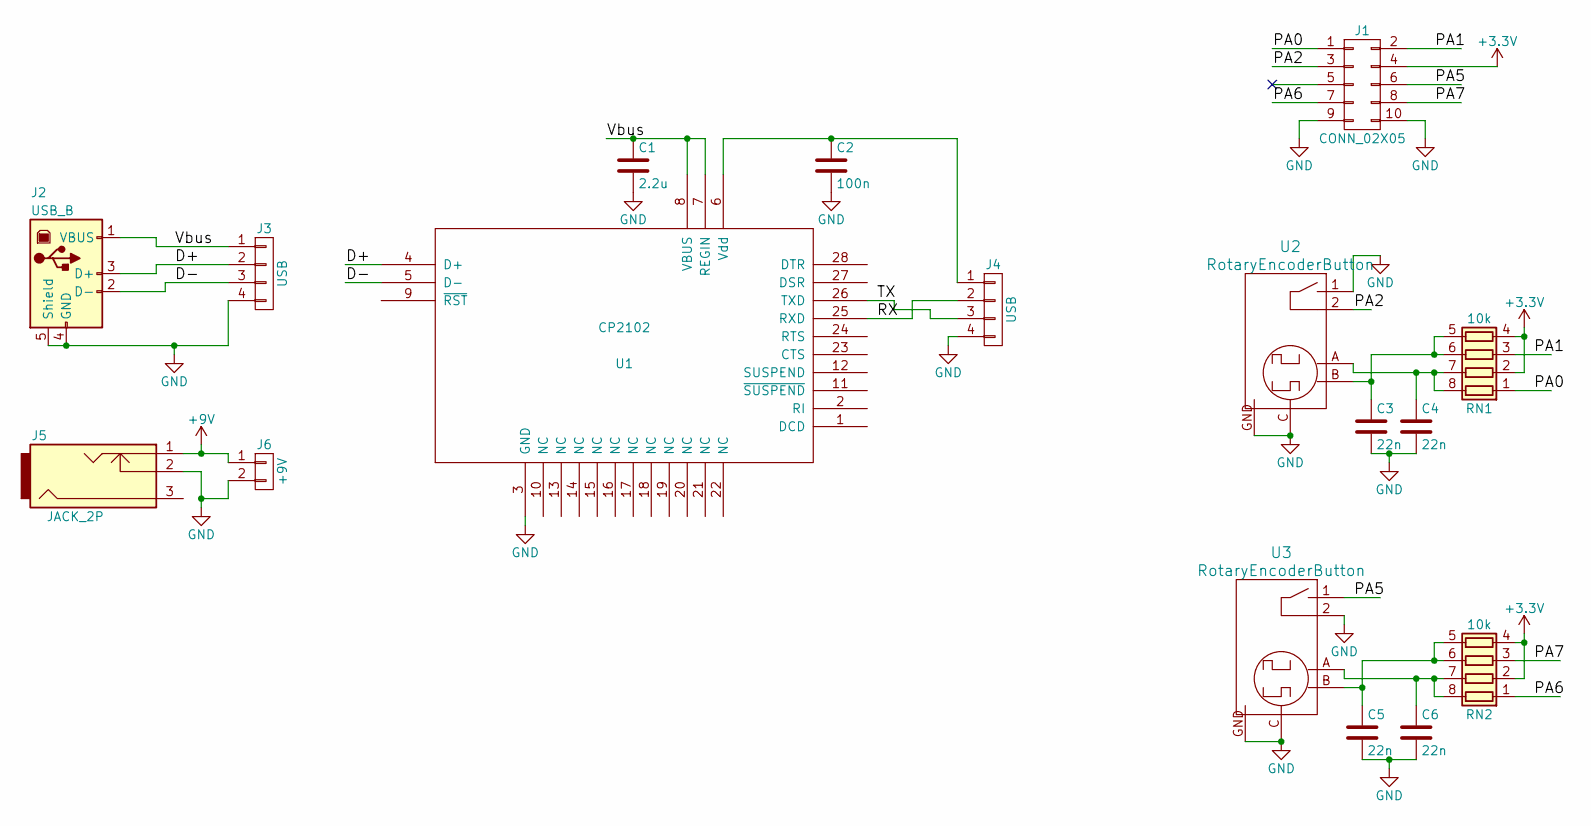
[picture p45: schematic rot_enc_and_power.sch]

Parts:
C1: 2.2u; C_0805
C2: 100n; C_0603
C3, C4, C5, C6: 22n; C_0603
J1: CONN_02X05; IDC_10M
J2: USB_B
J3, J4: USB; Pin_Header_Straight_1x04
J5: JACK_2P; JACK_ALIM
J6: +9V; Pin_Header_Straight_1x02
RN1, RN2: 10k; R_Array_Concave_4x0402
U1: CP2102; MLP-28
U2, U3: RotaryEncoderButton; RotEncButton

Connections:
+3V3: J1.4, RN1.2 (R2.1), RN1.4 (R4.1), RN2.2 (R2.1), RN2.4 (R4.1)
+9V: J5.1, J6.1
/D+: J2.3 (D+), J3.2, U1.4 (D+)
/D-: J2.2 (D-), J3.3, U1.5 (D-)
/PA0: J1.1, RN1.1 (R1.1)
/PA1: J1.2, RN1.3 (R3.1)
/PA2: J1.3, U2.2
/PA5: J1.6, U3.1
/PA6: J1.7, RN2.1 (R1.1)
/PA7: J1.8, RN2.3 (R3.1)
/RX: J4.2, U1.25 (RXD)
/TX: J4.3, U1.26 (TXD)
/Vbus: C1.1, J2.1 (VBUS), J3.1, U1.7 (REGIN), U1.8 (VBUS)
GND: C1.2, C2.2, C3.2, C4.2, C5.2, C6.2, J1.9, J1.10, J2.4 (GND), J2.5 (Shield), J3.4, J4.4, J5.2, J6.2, U1.3 (GND), U2.1, U2.C, U2.GND, U3.2, U3.C, U3.GND
unnamed: C2.1, J4.1, U1.6 (Vdd)
unnamed: C3.1, RN1.5 (R4.2), RN1.6 (R3.2), U2.B
unnamed: C4.1, RN1.7 (R2.2), RN1.8 (R1.2), U2.A
unnamed: C5.1, RN2.5 (R4.2), RN2.6 (R3.2), U3.B
unnamed: C6.1, RN2.7 (R2.2), RN2.8 (R1.2), U3.A

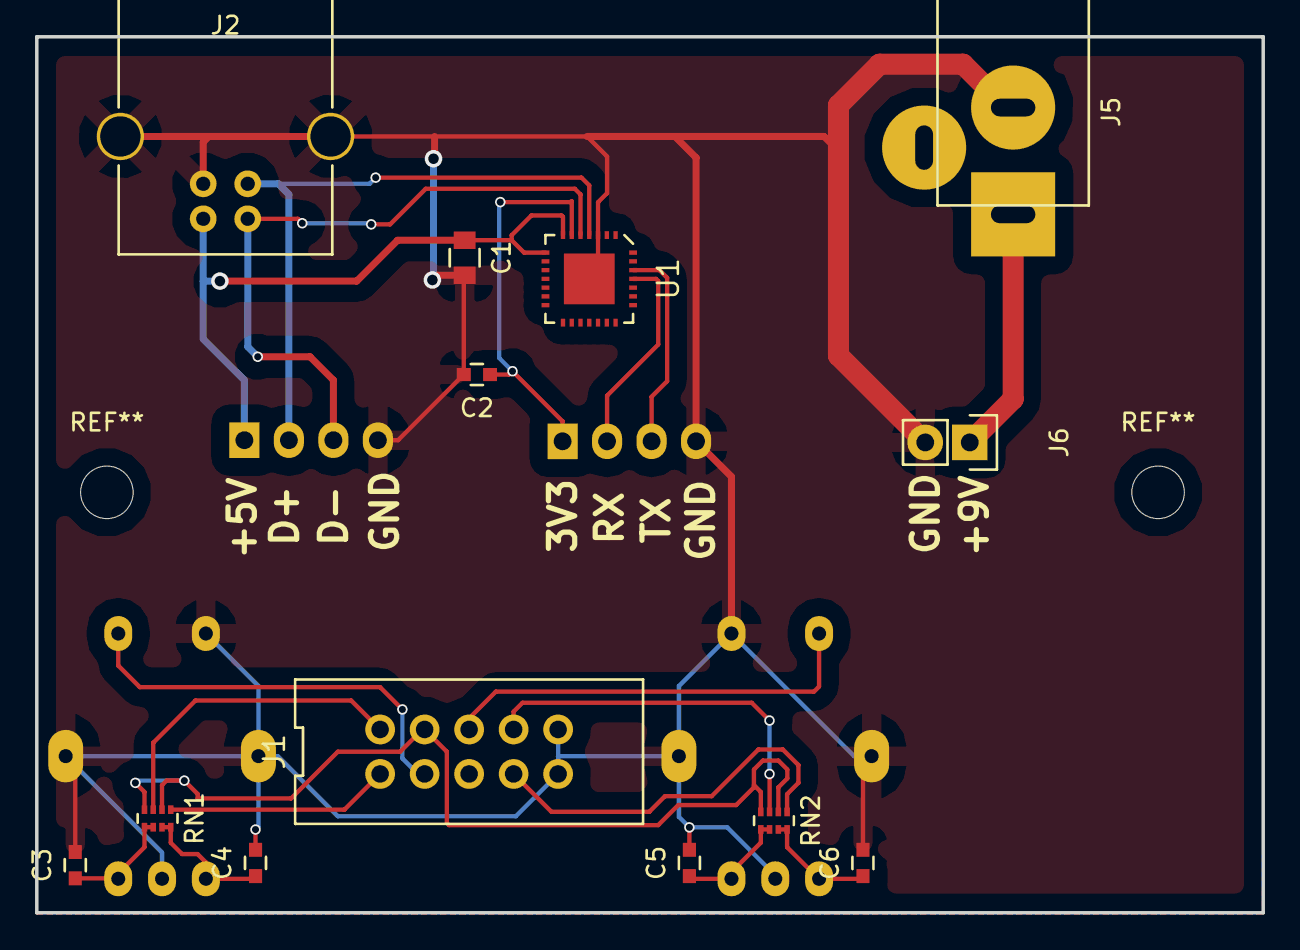
[picture p46: board rot_enc_and_power.kicad_pcb from above]

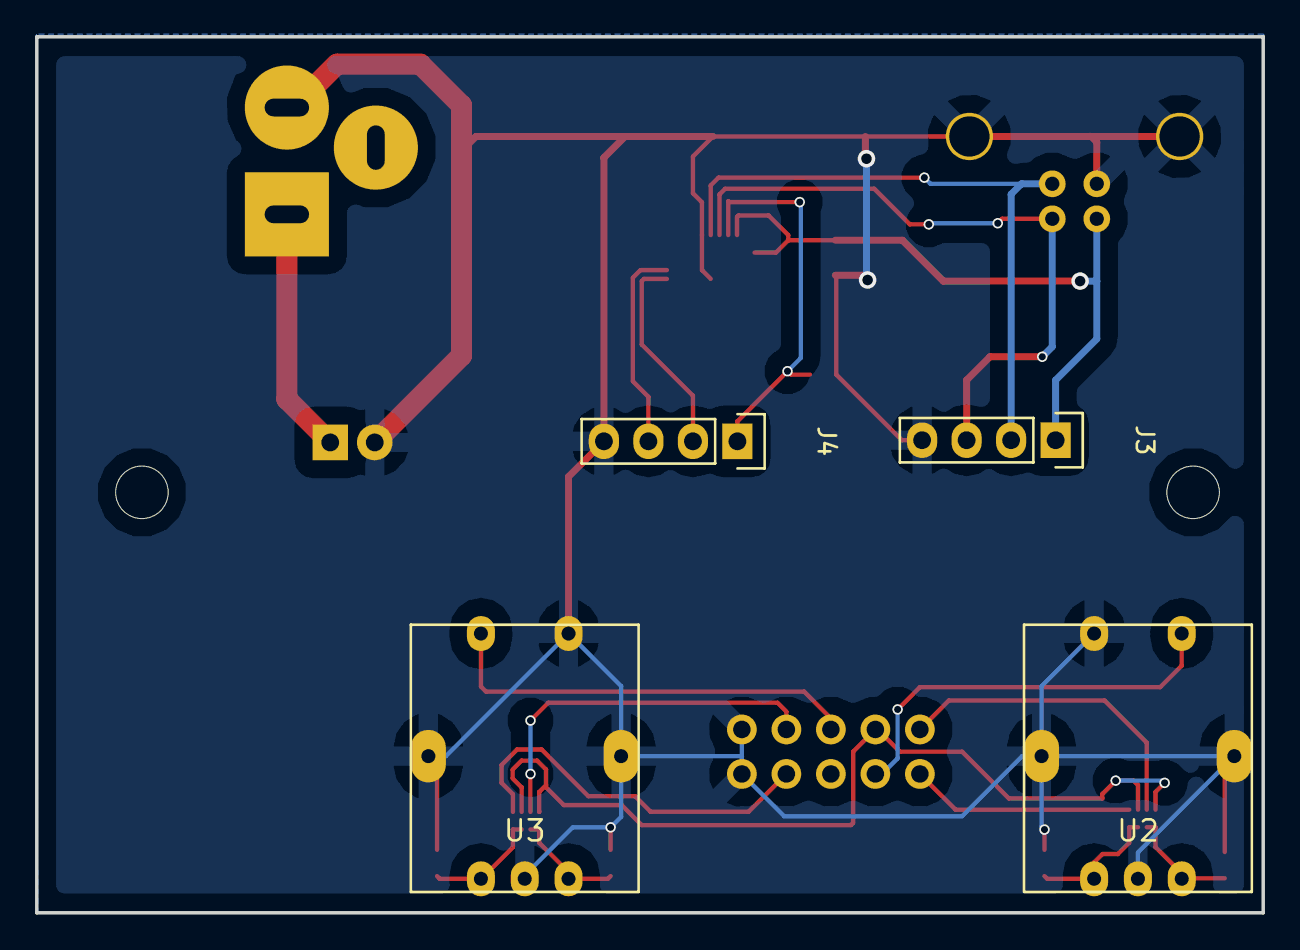
[picture p47: board rot_enc_and_power.kicad_pcb from below]

Board: 2 copper layers, 70.0 x 50.0 mm, 17 parts (4 on the bottom side), 19 nets.
