balmerdx/BalmerDX_VNA/circuit_kicad/digital_and_adc/digital_and_adc.kicad_pcb

## KiCad design circuit_kicad/digital_and_adc/digital_and_adc.kicad_pcb (2018-08-30)

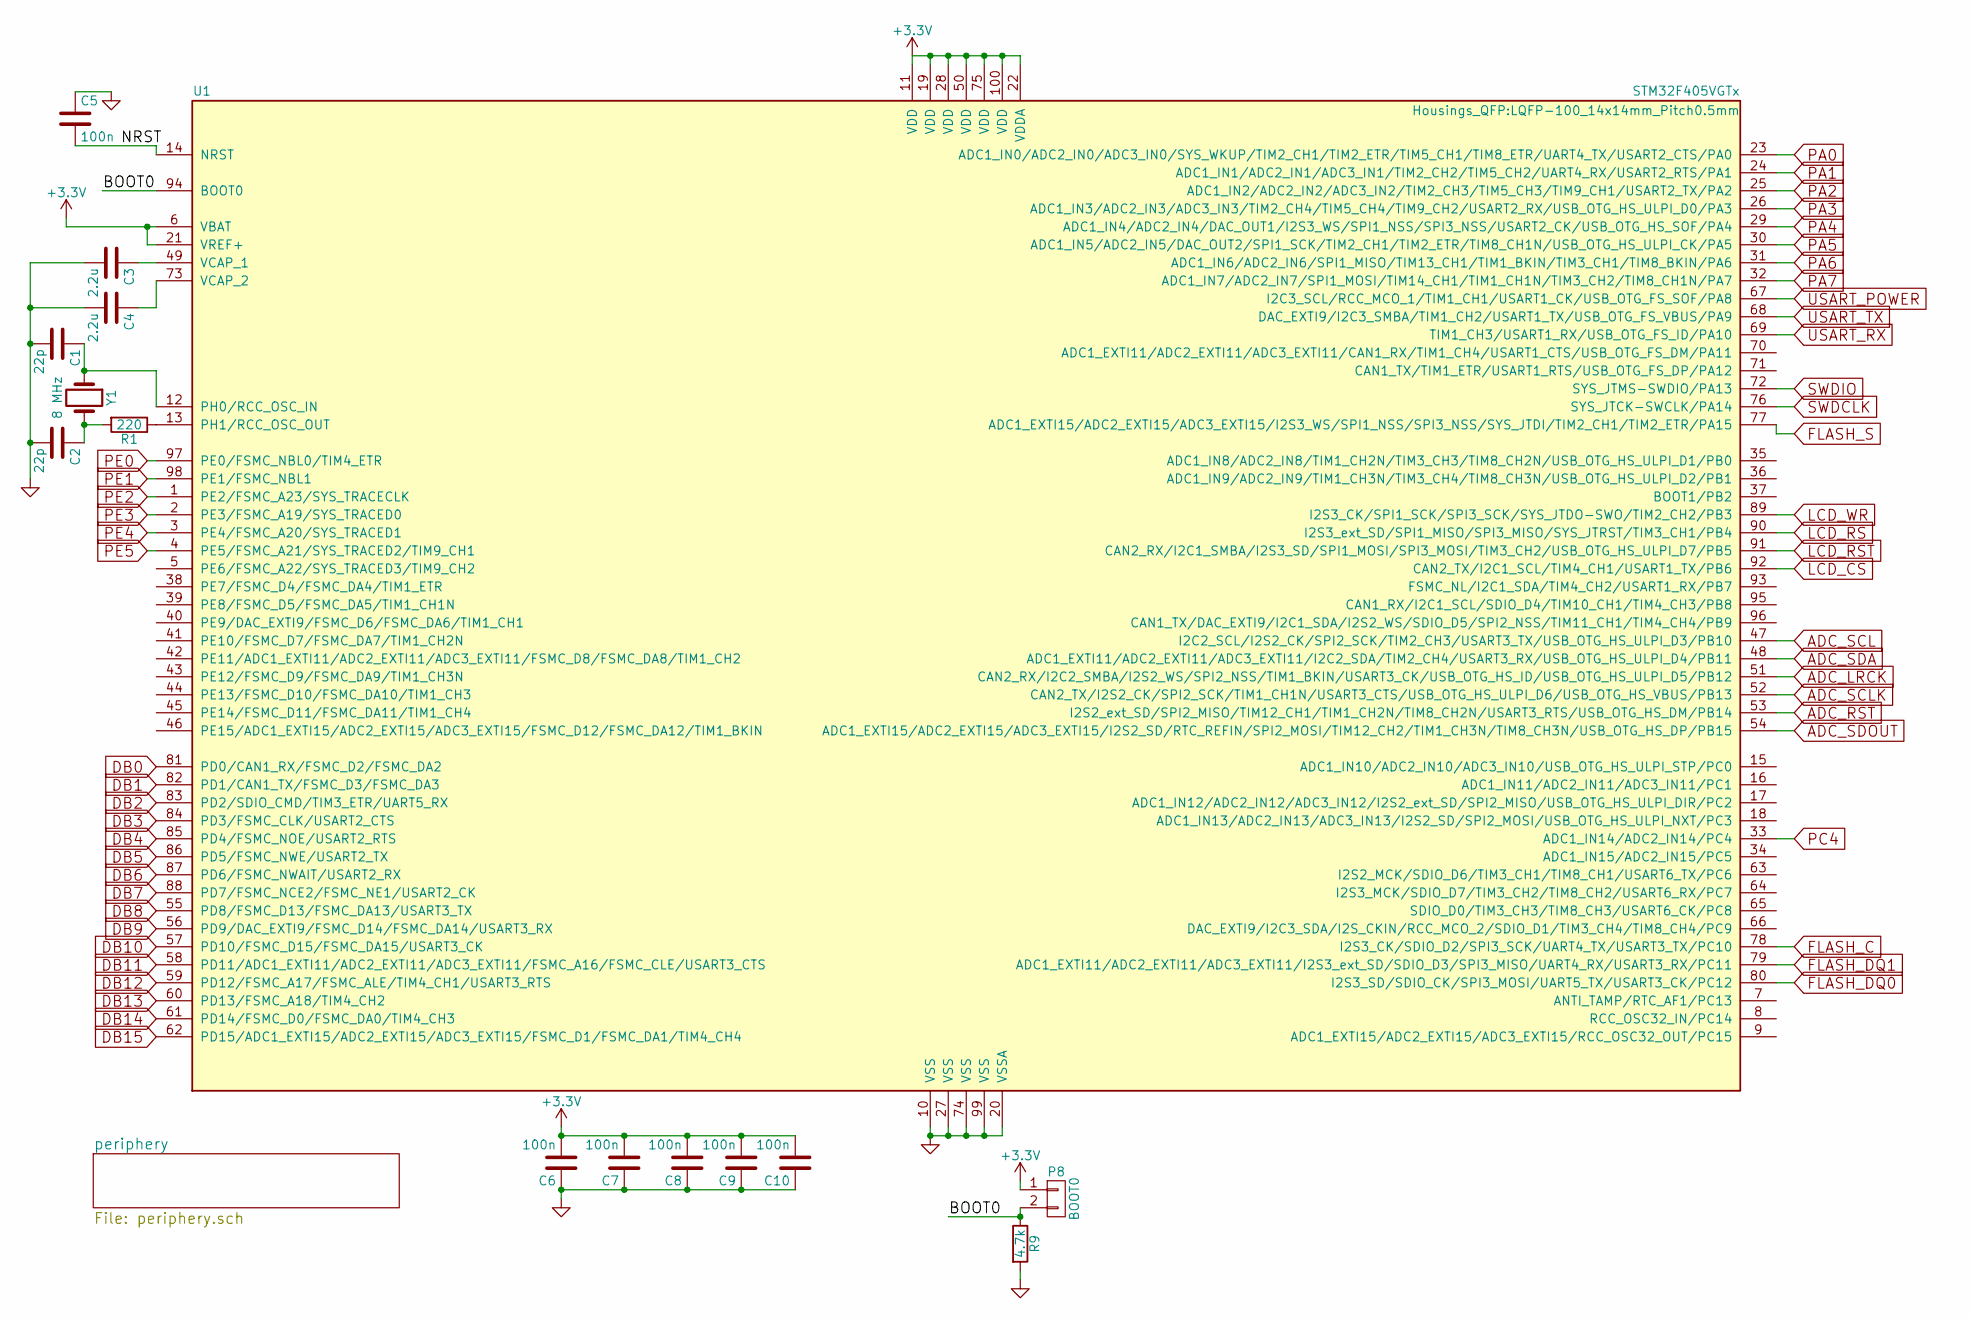
[picture p48: schematic digital_and_adc.sch]

Parts:
C1, C2: 22p; C_0603
C3, C4: 2.2u; C_0805
C5, C6, C7, C8, C9, C10: 100n; C_0603
P8: BOOT0; Pin_Header_Straight_1x02
R1: 220; R_0603
R9: 4.7k; R_0603
U1: STM32F405VGTx; LQFP-100_14x14mm_Pitch0.5mm
Y1: 8 MHz; Crystal_HC49-U_Vertical

Connections:
+3V3: C6.2, C7.2, C8.2, C9.2, C10.2, P8.1, U1.6 (VBAT), U1.11 (VDD), U1.19 (VDD), U1.21 (VREF+), U1.22 (VDDA), U1.28 (VDD), U1.50 (VDD), U1.75 (VDD), U1.100 (VDD); also elsewhere on the board
/BOOT0: P8.2, R9.1, U1.94 (BOOT0)
/NRST: C5.2, U1.14 (NRST)
ADC_LRCK: U1.51 (CAN2_RX/I2C2_SMBA/I2S2_WS/SPI2_NSS/TIM1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); also elsewhere on the board
ADC_RST: U1.53 (I2S2_ext_SD/SPI2_MISO/TIM12_CH1/TIM1_CH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); also elsewhere on the board
ADC_SCL: U1.47 (I2C2_SCL/I2S2_CK/SPI2_SCK/TIM2_CH3/USAR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); also elsewhere on the board
ADC_SCLK: U1.52 (CAN2_TX/I2S2_CK/SPI2_SCK/TIM1_CH1N/USAR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); also elsewhere on the board
ADC_SDA: U1.48 (ADC1_EXTI11/ADC2_EXTI11/ADC3_EXTI11/I2C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); also elsewhere on the board
ADC_SDOUT: U1.54 (ADC1_EXTI15/ADC2_EXTI15/ADC3_EXTI15/I2S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); also elsewhere on the board
DB0: U1.81 (PD0/CAN1_RX/FSMC_D2/FSMC_DA2); also elsewhere on the board
DB1: U1.82 (PD1/CAN1_TX/FSMC_D3/FSMC_DA3); also elsewhere on the board
DB2: U1.83 (PD2/SDIO_CMD/TIM3_ETR/UART5_RX); also elsewhere on the board
DB3: U1.84 (PD3/FSMC_CLK/USART2_CTS); also elsewhere on the board
DB4: U1.85 (PD4/FSMC_NOE/USART2_RTS); also elsewhere on the board
DB5: U1.86 (PD5/FSMC_NWE/USART2_TX); also elsewhere on the board
DB6: U1.87 (PD6/FSMC_NWAIT/USART2_RX); also elsewhere on the board
DB7: U1.88 (PD7/FSMC_NCE2/FSMC_NE1/USART2_CK); also elsewhere on the board
DB8: U1.55 (PD8/FSMC_D13/FSMC_DA13/USART3_TX); also elsewhere on the board
DB9: U1.56 (PD9/DAC_EXTI9/FSMC_D14/FSMC_DA14/USART3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); also elsewhere on the board
DB10: U1.57 (PD10/FSMC_D15/FSMC_DA15/USART3_CK); also elsewhere on the board
DB11: U1.58 (PD11/ADC1_EXTI11/ADC2_EXTI11/ADC3_EXTI1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); also elsewhere on the board
DB12: U1.59 (PD12/FSMC_A17/FSMC_ALE/TIM4_CH1/USART3_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); also elsewhere on the board
DB13: U1.60 (PD13/FSMC_A18/TIM4_CH2); also elsewhere on the board
DB14: U1.61 (PD14/FSMC_D0/FSMC_DA0/TIM4_CH3); also elsewhere on the board
DB15: U1.62 (PD15/ADC1_EXTI15/ADC2_EXTI15/ADC3_EXTI1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); also elsewhere on the board
FLASH_C: U1.78 (I2S3_CK/SDIO_D2/SPI3_SCK/UART4_TX/USART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); also elsewhere on the board
FLASH_DQ0: U1.80 (I2S3_SD/SDIO_CK/SPI3_MOSI/UART5_TX/USAR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); also elsewhere on the board
FLASH_DQ1: U1.79 (ADC1_EXTI11/ADC2_EXTI11/ADC3_EXTI11/I2S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); also elsewhere on the board
FLASH_S: U1.77 (ADC1_EXTI15/ADC2_EXTI15/ADC3_EXTI15/I2S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); also elsewhere on the board
GNDD: C1.2, C2.2, C3.2, C4.2, C5.1, C6.1, C7.1, C8.1, C9.1, C10.1, R9.2, U1.10 (VSS), U1.20 (VSSA), U1.27 (VSS), U1.74 (VSS), U1.99 (VSS); also elsewhere on the board
LCD_CS: U1.92 (CAN2_TX/I2C1_SCL/TIM4_CH1/USART1_TX/PB6); also elsewhere on the board
LCD_RS: U1.90 (I2S3_ext_SD/SPI1_MISO/SPI3_MISO/SYS_JTR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); also elsewhere on the board
LCD_RST: U1.91 (CAN2_RX/I2C1_SMBA/I2S3_SD/SPI1_MOSI/SPI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); also elsewhere on the board
LCD_WR: U1.89 (I2S3_CK/SPI1_SCK/SPI3_SCK/SYS_JTDO-SWO/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); also elsewhere on the board
unnamed: C1.1, U1.12 (PH0/RCC_OSC_IN), Y1.1
unnamed: C2.1, R1.2, Y1.2
unnamed: C3.1, U1.49 (VCAP_1)
unnamed: C4.1, U1.73 (VCAP_2)
unnamed: R1.1, U1.13 (PH1/RCC_OSC_OUT)
PA0: U1.23 (ADC1_IN0/ADC2_IN0/ADC3_IN0/SYS_WKUP/TIM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); also elsewhere on the board
PA1: U1.24 (ADC1_IN1/ADC2_IN1/ADC3_IN1/TIM2_CH2/TIM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); also elsewhere on the board
PA2: U1.25 (ADC1_IN2/ADC2_IN2/ADC3_IN2/TIM2_CH3/TIM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); also elsewhere on the board
PA3: U1.26 (ADC1_IN3/ADC2_IN3/ADC3_IN3/TIM2_CH4/TIM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); also elsewhere on the board
PA4: U1.29 (ADC1_IN4/ADC2_IN4/DAC_OUT1/I2S3_WS/SPI1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); also elsewhere on the board
PA5: U1.30 (ADC1_IN5/ADC2_IN5/DAC_OUT2/SPI1_SCK/TIM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); also elsewhere on the board
PA6: U1.31 (ADC1_IN6/ADC2_IN6/SPI1_MISO/TIM13_CH1/T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); also elsewhere on the board
PA7: U1.32 (ADC1_IN7/ADC2_IN7/SPI1_MOSI/TIM14_CH1/T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); also elsewhere on the board
PC4: U1.33 (ADC1_IN14/ADC2_IN14/PC4); also elsewhere on the board
PE0: U1.97 (PE0/FSMC_NBL0/TIM4_ETR); also elsewhere on the board
PE1: U1.98 (PE1/FSMC_NBL1); also elsewhere on the board
PE2: U1.1 (PE2/FSMC_A23/SYS_TRACECLK); also elsewhere on the board
PE3: U1.2 (PE3/FSMC_A19/SYS_TRACED0); also elsewhere on the board
PE4: U1.3 (PE4/FSMC_A20/SYS_TRACED1); also elsewhere on the board
PE5: U1.4 (PE5/FSMC_A21/SYS_TRACED2/TIM9_CH1); also elsewhere on the board
SWDCLK: U1.76 (SYS_JTCK-SWCLK/PA14); also elsewhere on the board
SWDIO: U1.72 (SYS_JTMS-SWDIO/PA13); also elsewhere on the board
USART_POWER: U1.67 (I2C3_SCL/RCC_MCO_1/TIM1_CH1/USART1_CK/U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); also elsewhere on the board
USART_RX: U1.69 (TIM1_CH3/USART1_RX/USB_OTG_FS_ID/PA10); also elsewhere on the board
USART_TX: U1.68 (DAC_EXTI9/I2C3_SMBA/TIM1_CH2/USART1_TX/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); also elsewhere on the board

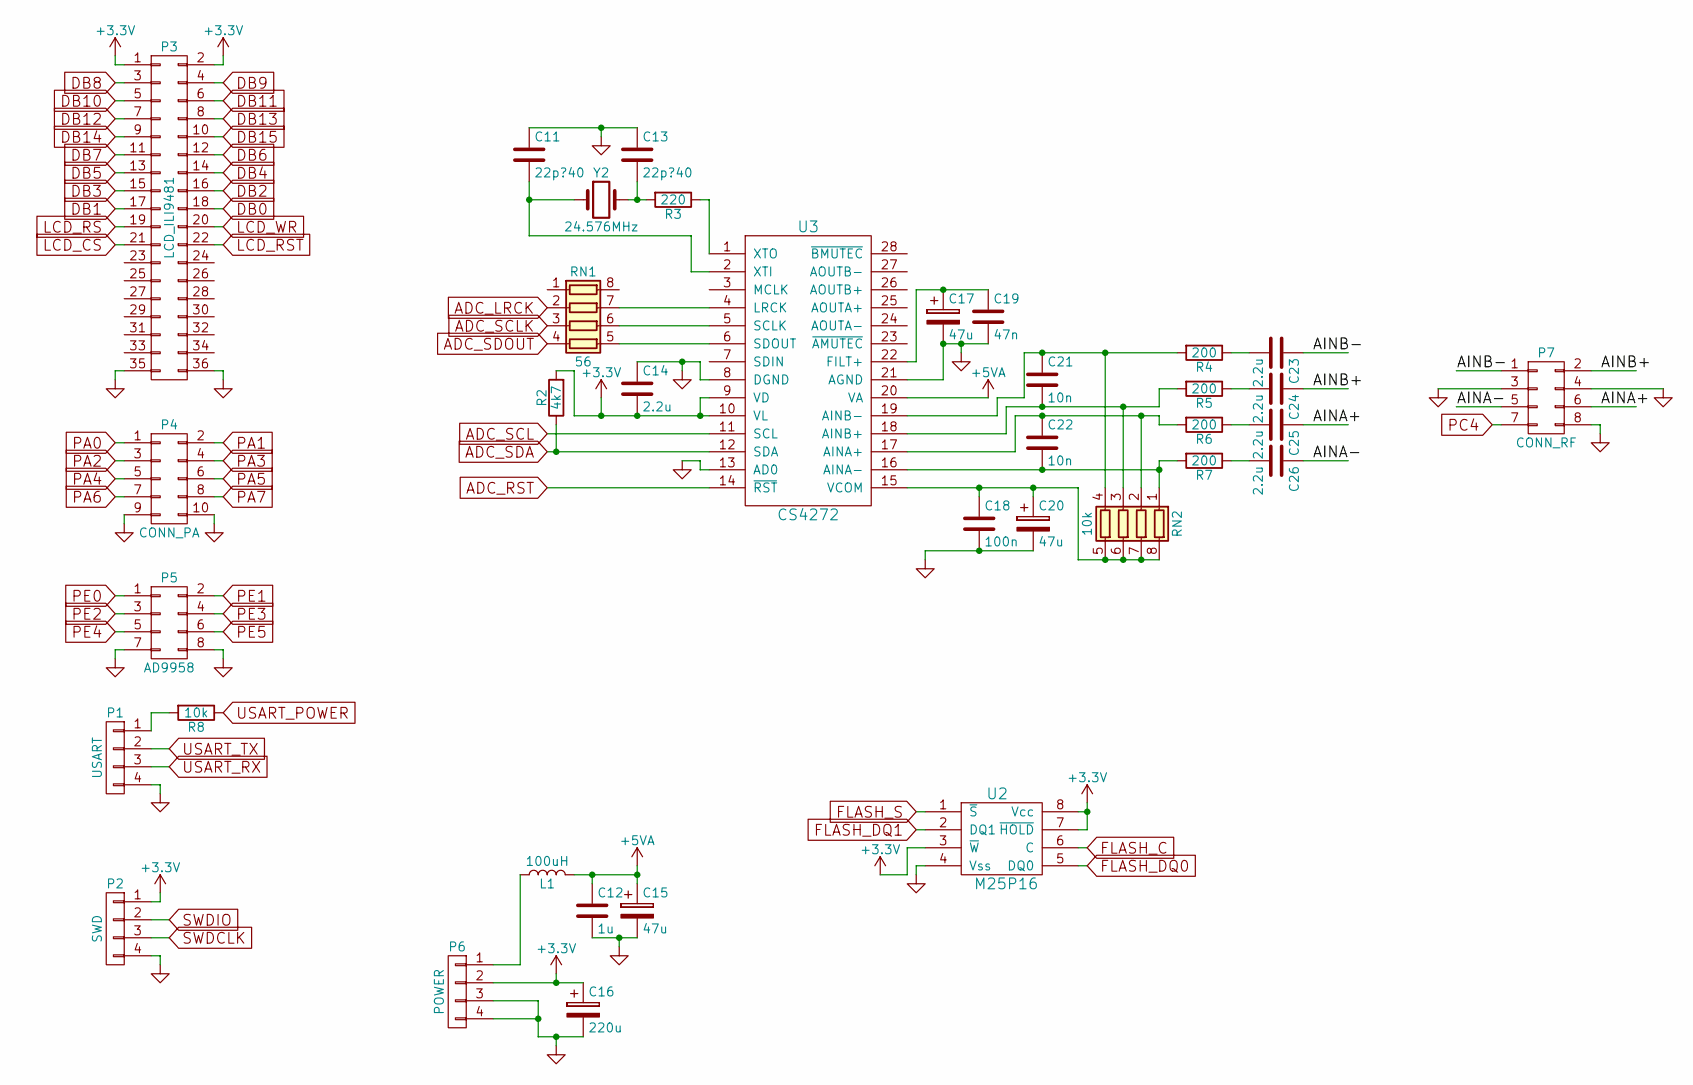
[picture p49: schematic periphery.sch]

Parts:
C11, C13: 22p?40; C_0603
C12: 1u; C_0805
C14, C23, C24, C25, C26: 2.2u; C_0805
C15, C17, C20: 47u; TantalC_SizeB_EIA-3528_HandSoldering
C16: 220u; c_elec_6.3x4.5
C18: 100n; C_0805
C19: 47n; C_0805
C21, C22: 10n; C_0603
L1: 100uH; Resistor_Horizontal_RM10mm
P1: USART; Pin_Header_Straight_1x04
P2: SWD; Pin_Header_Straight_1x04
P3: LCD_ILI9481; Pin_Header_Straight_2x18
P4: CONN_PA; Pin_Header_Straight_2x05
P5: AD9958; Pin_Header_Straight_2x04
P6: POWER; Pin_Header_Straight_1x04
P7: CONN_RF; Pin_Header_Straight_2x04
R2: 4k7; R_0603
R3: 220; R_0603
R4, R5, R6, R7: 200; R_0603
R8: 10k; R_0603
RN1: 56; R_Array_Concave_4x0402
RN2: 10k; R_Array_Concave_4x0402
U2: M25P16; SOIC-8-N
U3: CS4272; TSSOP-28_4.4x9.7mm_Pitch0.65mm
Y2: 24.576MHz; Crystal_HC49-U_Vertical

Connections:
+3V3: C14.2, C16.1, P2.1, P3.1, P3.2, P6.2, R2.2, U2.3 (~W), U2.7 (~HOLD), U2.8 (Vcc), U3.9 (VD), U3.10 (VL); also elsewhere on the board
+5VA: C12.1, C15.1, L1.2, U3.20 (VA)
/periphery/AINA+: C25.1, P7.6
/periphery/AINA-: C26.1, P7.5
/periphery/AINB+: C24.1, P7.2
/periphery/AINB-: C23.1, P7.1
ADC_LRCK: RN1.2 (R2.1); also elsewhere on the board
ADC_RST: U3.14 (~RST); also elsewhere on the board
ADC_SCL: U3.11 (SCL); also elsewhere on the board
ADC_SCLK: RN1.3 (R3.1); also elsewhere on the board
ADC_SDA: R2.1, U3.12 (SDA); also elsewhere on the board
ADC_SDOUT: RN1.4 (R4.1); also elsewhere on the board
DB0: P3.18; also elsewhere on the board
DB1: P3.17; also elsewhere on the board
DB2: P3.16; also elsewhere on the board
DB3: P3.15; also elsewhere on the board
DB4: P3.14; also elsewhere on the board
DB5: P3.13; also elsewhere on the board
DB6: P3.12; also elsewhere on the board
DB7: P3.11; also elsewhere on the board
DB8: P3.3; also elsewhere on the board
DB9: P3.4; also elsewhere on the board
DB10: P3.5; also elsewhere on the board
DB11: P3.6; also elsewhere on the board
DB12: P3.7; also elsewhere on the board
DB13: P3.8; also elsewhere on the board
DB14: P3.9; also elsewhere on the board
DB15: P3.10; also elsewhere on the board
FLASH_C: U2.6 (C); also elsewhere on the board
FLASH_DQ0: U2.5 (DQ0); also elsewhere on the board
FLASH_DQ1: U2.2 (DQ1); also elsewhere on the board
FLASH_S: U2.1 (~S); also elsewhere on the board
GNDD: C11.1, C12.2, C13.1, C14.1, C15.2, C16.2, C17.2, C18.2, C19.2, C20.2, P1.4, P2.4, P3.35, P3.36, P4.9, P4.10, P5.7, P5.8, P6.3, P6.4, P7.3, P7.4, P7.8, U2.4 (Vss), U3.8 (DGND), U3.13 (AD0), U3.21 (AGND); also elsewhere on the board
LCD_CS: P3.21; also elsewhere on the board
LCD_RS: P3.19; also elsewhere on the board
LCD_RST: P3.22; also elsewhere on the board
LCD_WR: P3.20; also elsewhere on the board
unnamed: C11.2, U3.2 (XTI), Y2.1
unnamed: C13.2, R3.2, Y2.2
unnamed: C17.1, C19.1, U3.22 (FILT+)
unnamed: C18.1, C20.1, RN2.5 (R4.2), RN2.6 (R3.2), RN2.7 (R2.2), RN2.8 (R1.2), U3.15 (VCOM)
unnamed: C21.1, R4.2, RN2.4 (R4.1), U3.19 (AINB-)
unnamed: C21.2, R5.2, RN2.3 (R3.1), U3.18 (AINB+)
unnamed: C22.1, R6.2, RN2.2 (R2.1), U3.17 (AINA+)
unnamed: C22.2, R7.2, RN2.1 (R1.1), U3.16 (AINA-)
unnamed: C23.2, R4.1
unnamed: C24.2, R5.1
unnamed: C25.2, R6.1
unnamed: C26.2, R7.1
unnamed: L1.1, P6.1
unnamed: P1.1, R8.2
unnamed: R3.1, U3.1 (XTO)
unnamed: RN1.5 (R4.2), U3.6 (SDOUT)
unnamed: RN1.6 (R3.2), U3.5 (SCLK)
unnamed: RN1.7 (R2.2), U3.4 (LRCK)
PA0: P4.1; also elsewhere on the board
PA1: P4.2; also elsewhere on the board
PA2: P4.3; also elsewhere on the board
PA3: P4.4; also elsewhere on the board
PA4: P4.5; also elsewhere on the board
PA5: P4.6; also elsewhere on the board
PA6: P4.7; also elsewhere on the board
PA7: P4.8; also elsewhere on the board
PC4: P7.7; also elsewhere on the board
PE0: P5.1; also elsewhere on the board
PE1: P5.2; also elsewhere on the board
PE2: P5.3; also elsewhere on the board
PE3: P5.4; also elsewhere on the board
PE4: P5.5; also elsewhere on the board
PE5: P5.6; also elsewhere on the board
SWDCLK: P2.3; also elsewhere on the board
SWDIO: P2.2; also elsewhere on the board
USART_POWER: R8.1; also elsewhere on the board
USART_RX: P1.3; also elsewhere on the board
USART_TX: P1.2; also elsewhere on the board

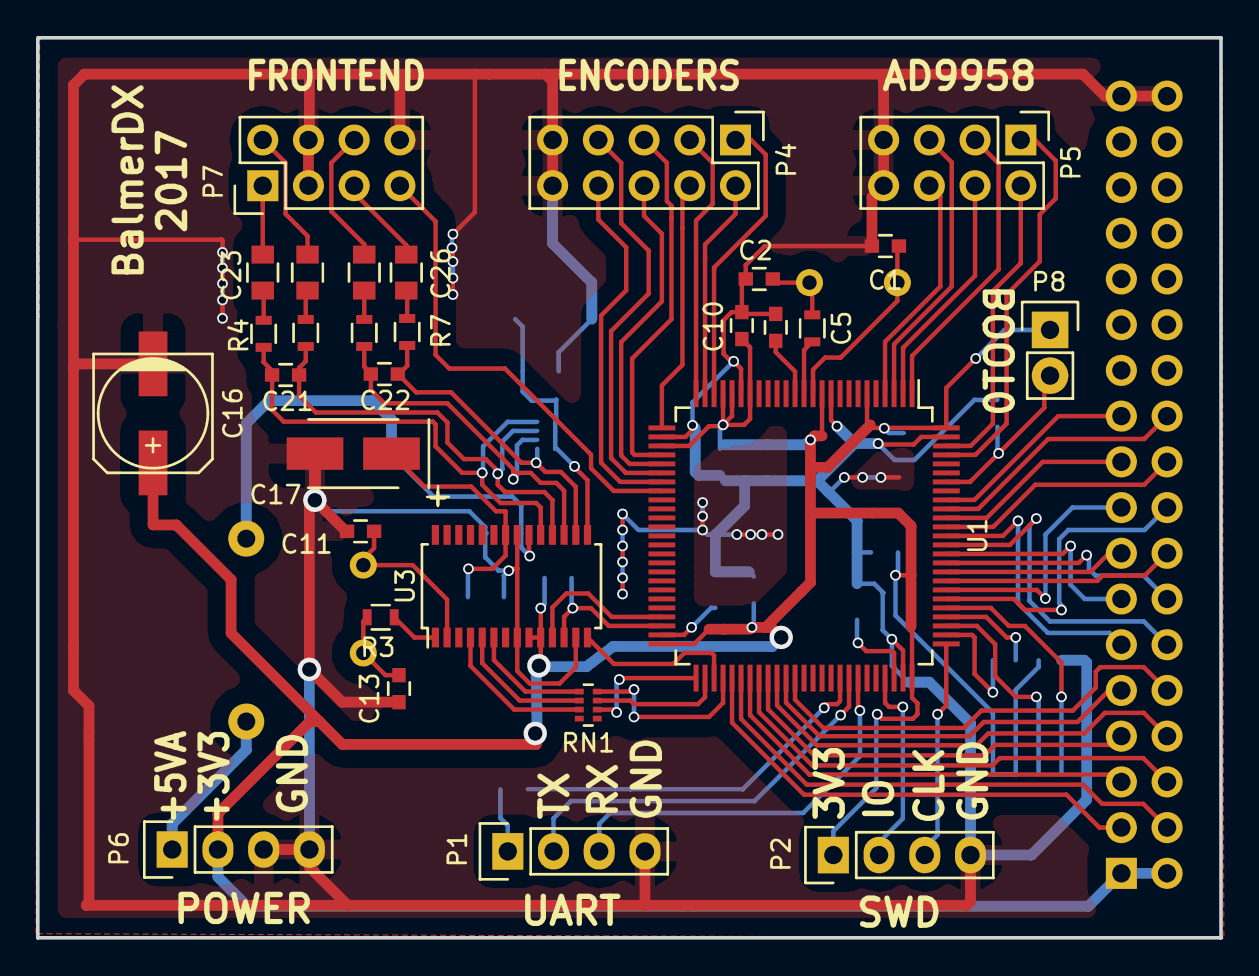
[picture p50: board digital_and_adc.kicad_pcb from above]

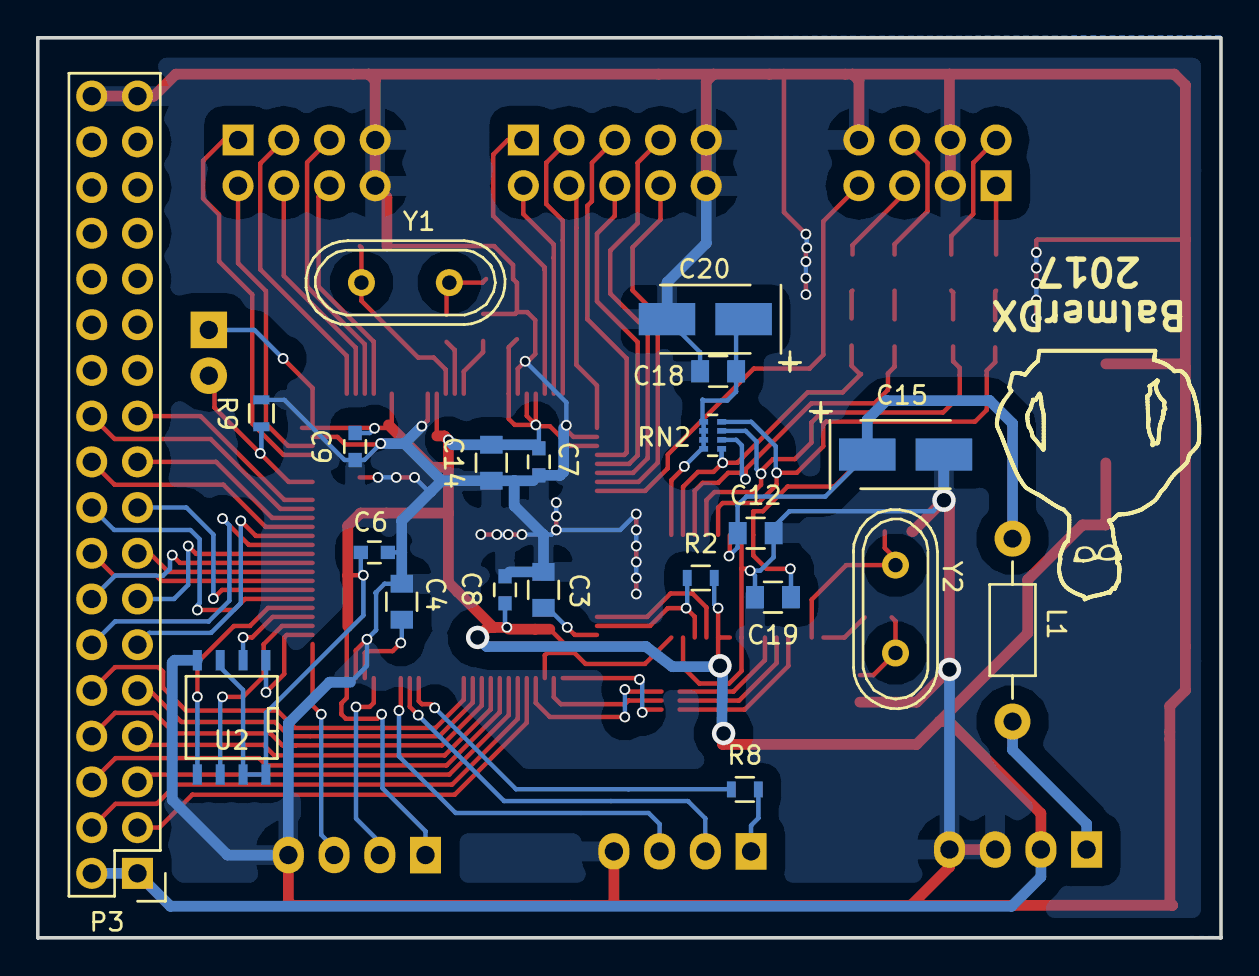
[picture p51: board digital_and_adc.kicad_pcb from below]

Board: 2 copper layers, 65.7 x 50.0 mm, 52 parts (22 on the bottom side), 82 nets.

Other parts of the board:
balmer_logo: balmer; balmer_logo
