balmerdx/BalmerDX_VNA/circuit_kicad/analog_and_ad9958/analog_and_ad9958.kicad_pcb

## KiCad design circuit_kicad/analog_and_ad9958/analog_and_ad9958.kicad_pcb (2018-08-30)

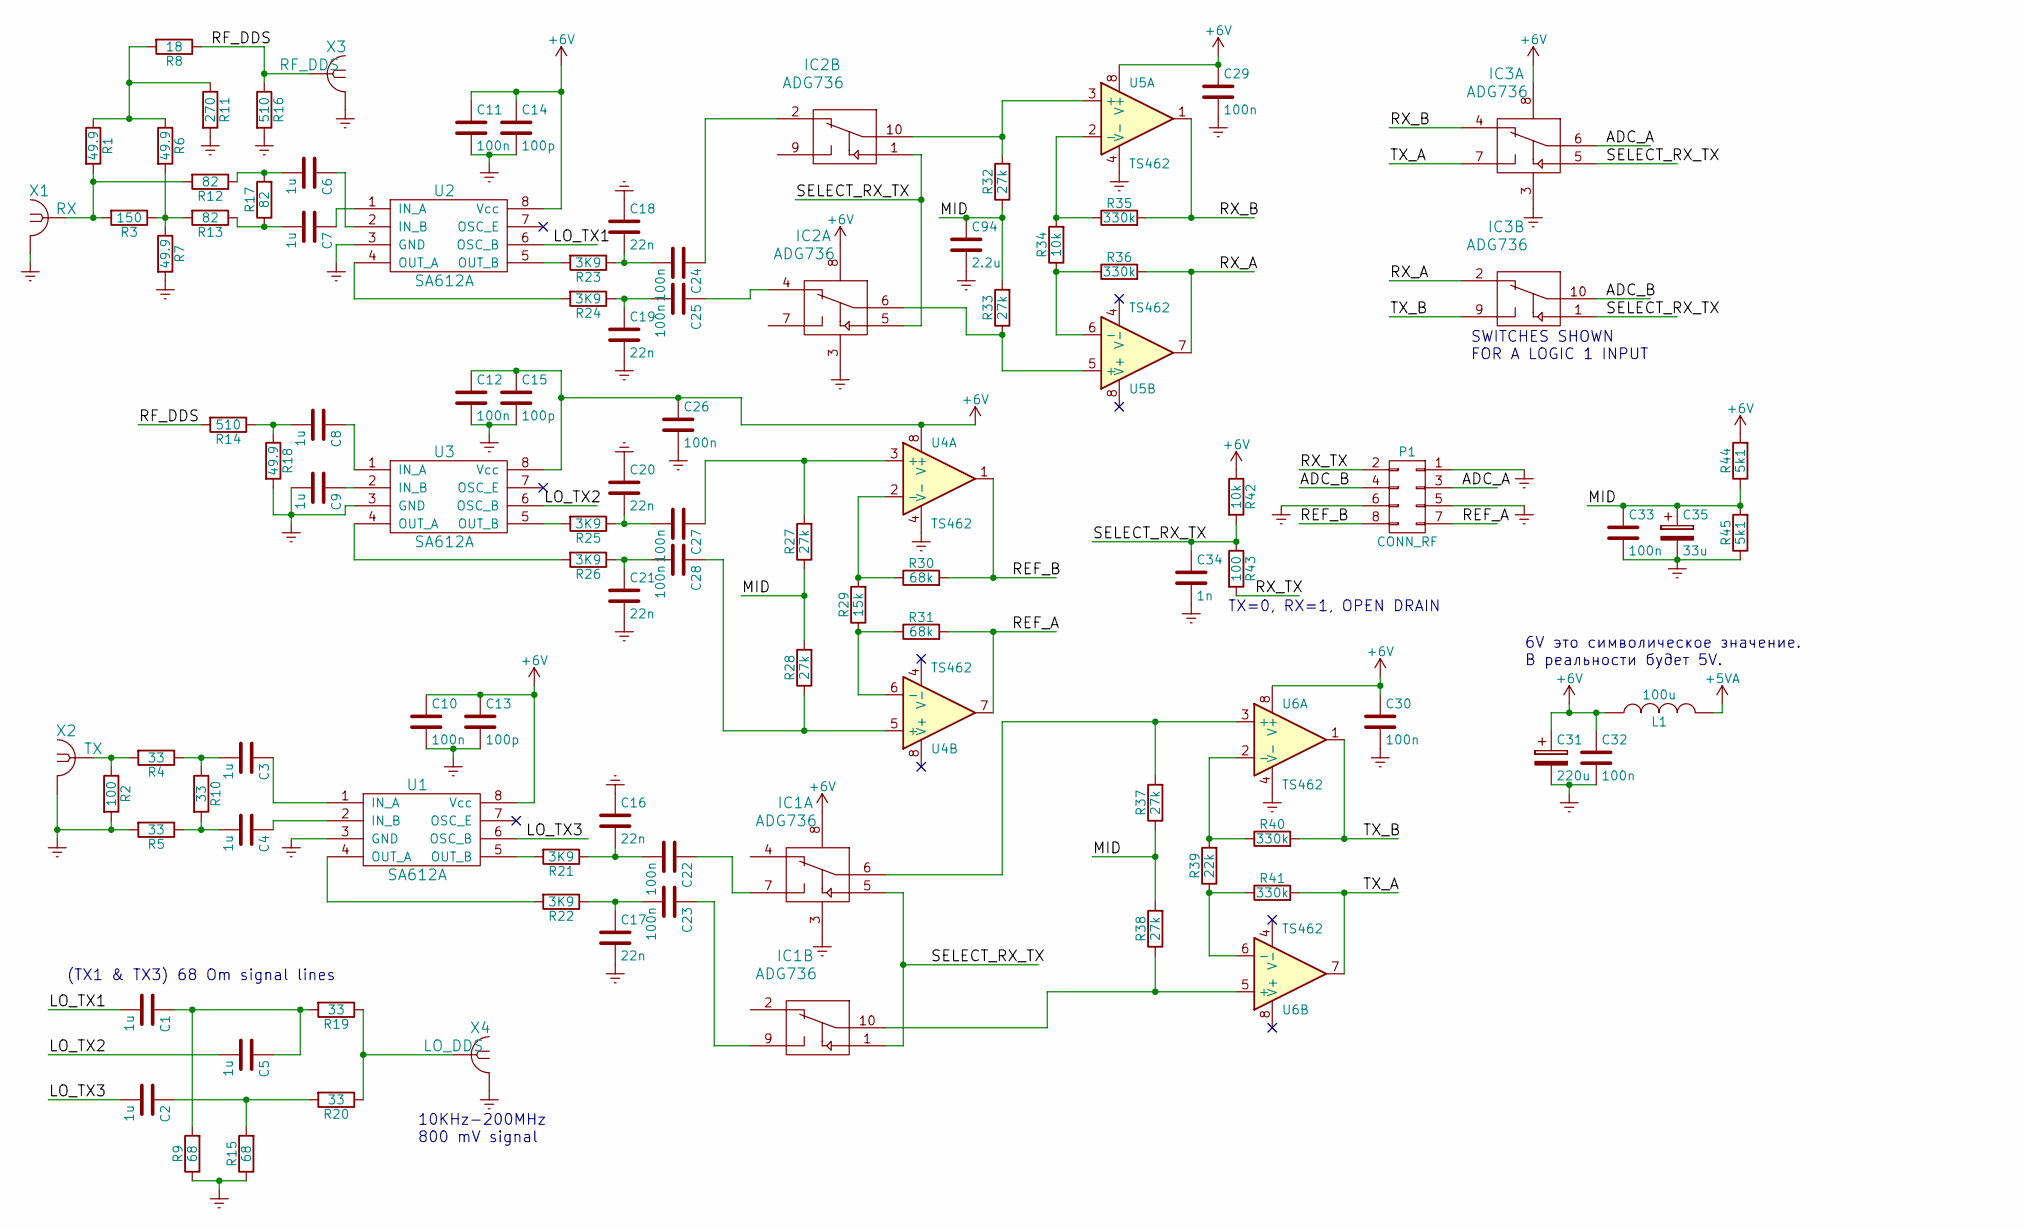
[picture p52: schematic analog_sa612A.sch]

Parts:
C1, C2, C3, C4, C5, C6, C7, C8, C9: 1u; C_0603
C10, C11, C12, C22, C23, C24, C25, C26, C27, C28, C29, C30, C32, C33: 100n; C_0603
C13, C14, C15: 100p; C_0603
C16, C17, C18, C19, C20, C21: 22n; C_0603
C31: 220u; c_elec_6.3x4.5
C34: 1n; C_0603
C35: 33u; c_elec_6.3x4.5
C94: 2.2u; C_0805
IC1, IC2, IC3: ADG736; MSOP-10_3x3mm_Pitch0.5mm
L1: 100u; Resistor_Horizontal_RM10mm
P1: CONN_RF; IDC_08M
R1, R6, R7, R18: 49.9; R_0603
R2, R43: 100; R_0603
R3: 150; R_0603
R4, R5, R10: 33; R_0603
R8: 18; R_0603
R9, R15: 68; R_0805
R11: 270; R_0603
R12, R13, R17: 82; R_0603
R14, R16: 510; R_0603
R19, R20: 33; R_0805
R21, R22, R23, R24, R25, R26: 3K9; R_0603
R27, R28, R32, R33, R37, R38: 27k; R_0603
R29: 15k; R_0603
R30, R31: 68k; R_0603
R34, R42: 10k; R_0603
R35, R36, R40, R41: 330k; R_0603
R39: 22k; R_0603
R44, R45: 5k1; R_0603
U1, U2, U3: SA612A; SOIC-8-N
U4, U5, U6: TS462; SOIC-8-N
X1: RX; SMA-NORMAL
X2: TX; SMA-NORMAL
X3: RF_DDS; SMA-NORMAL-MY
X4: LO_DDS; SMA-NORMAL-MY

Connections:
+5VA: L1.2; also elsewhere on the board
+6V: C10.1, C11.1, C12.1, C13.1, C14.1, C15.1, C26.1, C29.1, C30.1, C31.1, C32.1, IC1.8, IC2.8, IC3.8, L1.1, R42.1, R44.2, U1.8 (Vcc), U2.8 (Vcc), U3.8 (Vcc), U4.8 (V+), U5.8 (V+), U6.8 (V+)
/analog_sa612A/ADC_A: IC3.6, P1.3
/analog_sa612A/ADC_B: IC3.10, P1.4
/analog_sa612A/LO_TX1: C1.2, U2.6 (OSC_B)
/analog_sa612A/LO_TX2: C5.2, U3.6 (OSC_B)
/analog_sa612A/LO_TX3: C2.2, U1.6 (OSC_B)
/analog_sa612A/MID: C33.1, C35.1, C94.1, R27.1, R28.2, R32.1, R33.2, R37.1, R38.2, R44.1, R45.2
/analog_sa612A/REF_A: P1.7, R31.2, U4.7
/analog_sa612A/REF_B: P1.8, R30.2, U4.1
/analog_sa612A/RF_DDS: R8.1, R14.2, R16.1, X3.1
/analog_sa612A/RX_A: IC3.2, R36.2, U5.7
/analog_sa612A/RX_B: IC3.4, R35.2, U5.1
/analog_sa612A/RX_TX: P1.2, R43.2
/analog_sa612A/SELECT_RX_TX: C34.1, IC1.1, IC1.5, IC2.1, IC2.5, IC3.1, IC3.5, R42.2, R43.1
/analog_sa612A/TX_A: IC3.7, R41.2, U6.7
/analog_sa612A/TX_B: IC3.9, R40.2, U6.1
Earth: C9.2, C10.2, C11.2, C12.2, C13.2, C14.2, C15.2, C16.1, C17.2, C18.1, C19.2, C20.1, C21.2, C26.2, C29.2, C30.2, C31.2, C32.2, C33.2, C34.2, C35.2, C94.2, IC1.3, IC2.3, IC3.3, P1.1, P1.5, P1.6, R2.2, R5.2, R7.2, R9.1, R11.2, R15.1, R16.2, R18.2, R45.1, U1.3 (GND), U2.3 (GND), U3.3 (GND), U4.4 (V-), U5.4 (V-), U6.4 (V-), X1.2 (GND), X2.2 (GND), X3.2 (GND), X4.2 (GND); also elsewhere on the board
unnamed: C1.1, C5.1, R9.2, R19.2
unnamed: C2.1, R15.2, R20.2
unnamed: C3.1, U1.1 (IN_A)
unnamed: C3.2, R4.1, R10.1
unnamed: C4.1, U1.2 (IN_B)
unnamed: C4.2, R5.1, R10.2
unnamed: C6.1, U2.2 (IN_B)
unnamed: C6.2, R12.1, R17.2
unnamed: C7.1, U2.1 (IN_A)
unnamed: C7.2, R13.1, R17.1
unnamed: C8.1, U3.1 (IN_A)
unnamed: C8.2, R14.1, R18.1
unnamed: C9.1, U3.2 (IN_B)
unnamed: C16.2, C22.2, R21.1
unnamed: C17.1, C23.2, R22.1
unnamed: C18.2, C24.2, R23.1
unnamed: C19.1, C25.2, R24.1
unnamed: C20.2, C27.2, R25.1
unnamed: C21.1, C28.2, R26.1
unnamed: C22.1, IC1.7
unnamed: C23.1, IC1.9
unnamed: C24.1, IC2.2
unnamed: C25.1, IC2.4
unnamed: C27.1, R27.2, U4.3 (+)
unnamed: C28.1, R28.1, U4.5 (+)
unnamed: IC1.6, R37.2, U6.3 (+)
unnamed: IC1.10, R38.1, U6.5 (+)
unnamed: IC2.6, R33.1, U5.5 (+)
unnamed: IC2.10, R32.2, U5.3 (+)
unnamed: R1.1, R6.1, R8.2, R11.1
unnamed: R1.2, R3.2, R12.2, X1.1
unnamed: R2.1, R4.2, X2.1
unnamed: R3.1, R6.2, R7.1, R13.2
unnamed: R19.1, R20.1, X4.1
unnamed: R21.2, U1.5 (OUT_B)
unnamed: R22.2, U1.4 (OUT_A)
unnamed: R23.2, U2.5 (OUT_B)
unnamed: R24.2, U2.4 (OUT_A)
unnamed: R25.2, U3.5 (OUT_B)
unnamed: R26.2, U3.4 (OUT_A)
unnamed: R29.1, R31.1, U4.6 (-)
unnamed: R29.2, R30.1, U4.2 (-)
unnamed: R34.1, R36.1, U5.6 (-)
unnamed: R34.2, R35.1, U5.2 (-)
unnamed: R39.1, R41.1, U6.6 (-)
unnamed: R39.2, R40.1, U6.2 (-)

Notes on the sheet:
SWITCHES SHOWN FOR A LOGIC 1 INPUT
TX=0, RX=1, OPEN DRAIN
(TX1 & TX3) 68 Om signal lines
10KHz-200MHz 800 mV signal
6V это символическое значение. В реальности будет 5V.
