balmerdx/BalmerDX_VNA/circuit_kicad/analog_and_ad9958/analog_and_ad9958.kicad_pcb

## KiCad design circuit_kicad/analog_and_ad9958/analog_and_ad9958.kicad_pcb (continued)

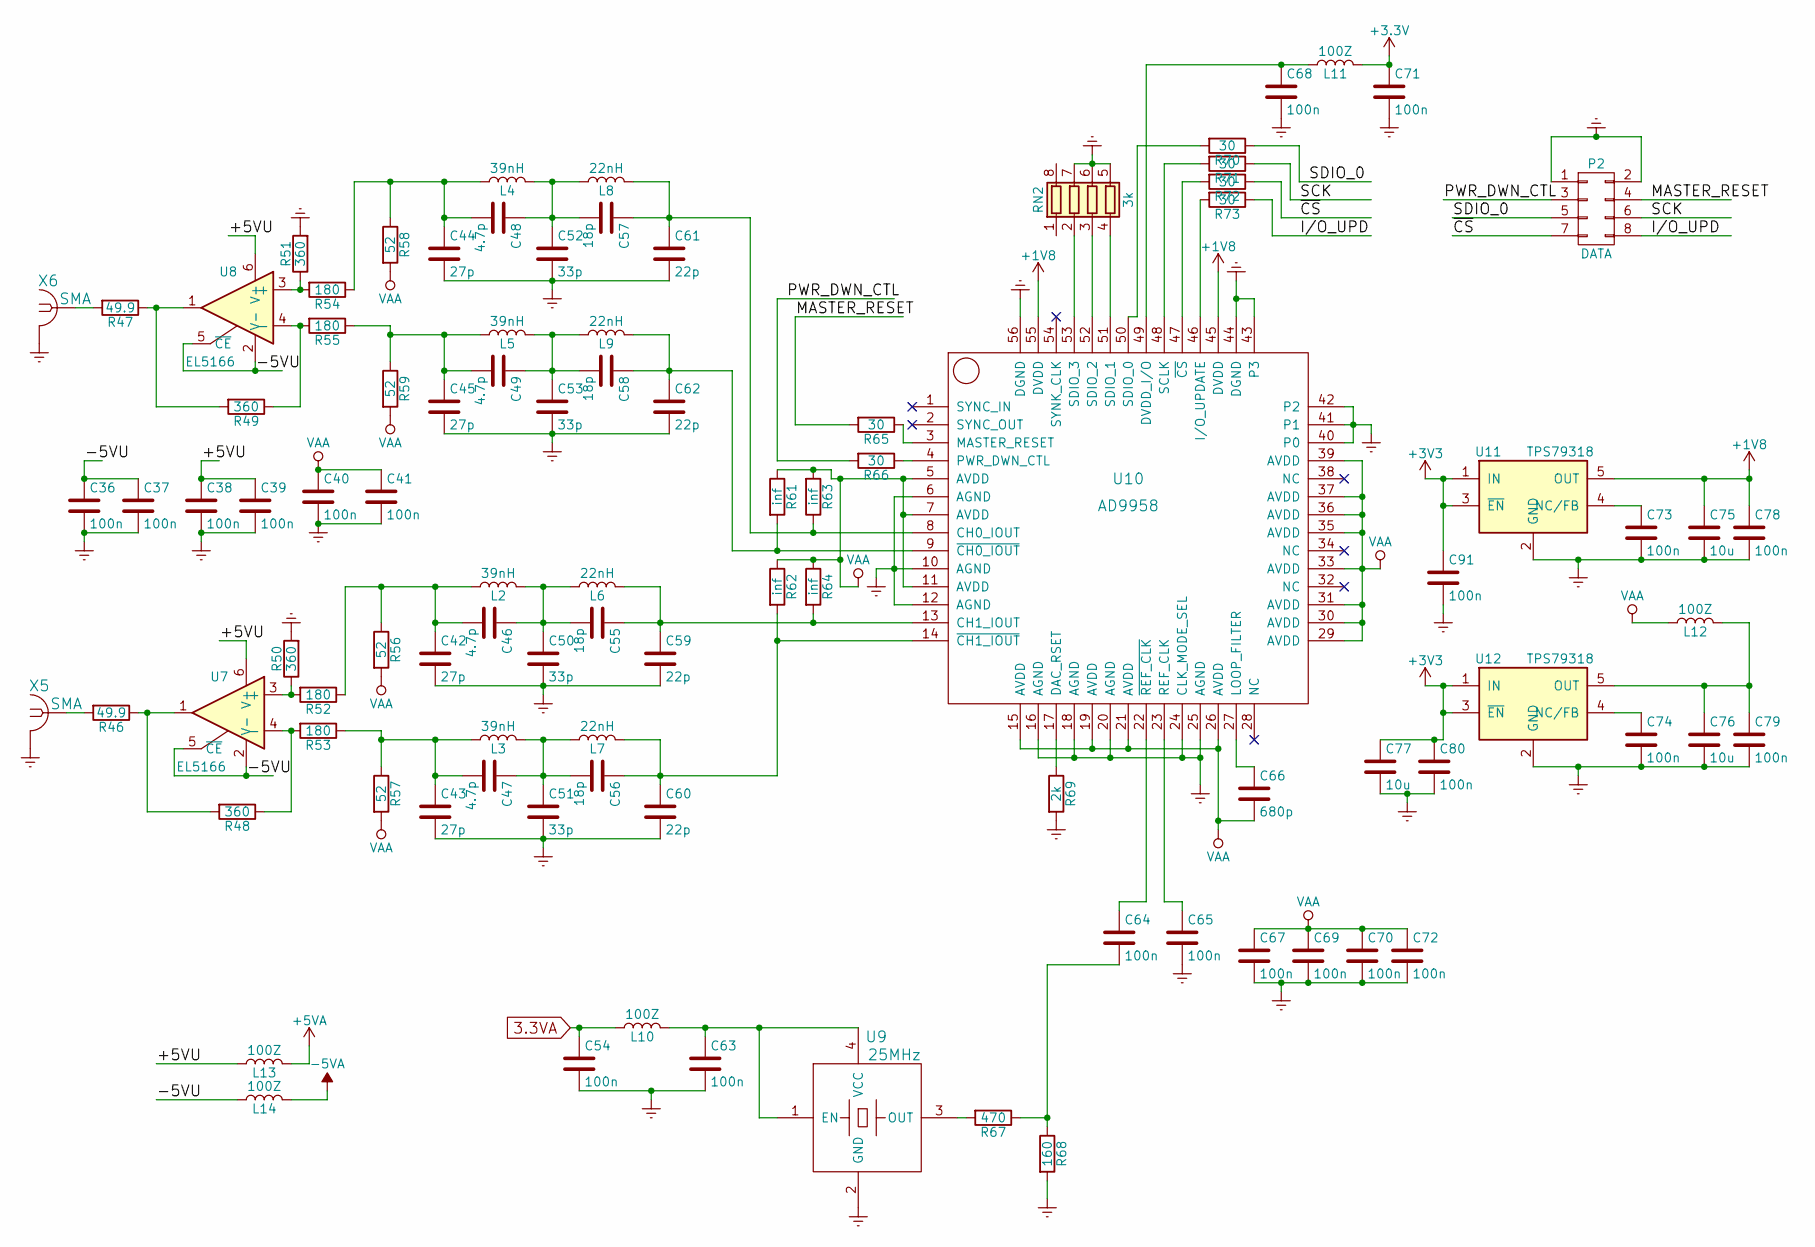
[picture p53: schematic generator_AD9958.sch]

Parts:
C36, C37, C38, C39, C40, C41, C54, C63, C64, C65, C67, C68, C69, C70, C71, C72, C73, C74, C78, C79, C80, C91: 100n; C_0603
C42, C43, C44, C45: 27p; R_0805
C46, C47, C48, C49: 4.7p; R_0805
C50, C51, C52, C53: 33p; R_0805
C55, C56, C57, C58: 18p; R_0805
C59, C60, C61, C62: 22p; R_0805
C66: 680p; C_0603
C75, C76, C77: 10u; C_0805
L2, L3, L4, L5: 39nH; R_0805_HandSoldering
L6, L7, L8, L9: 22nH; R_0805_HandSoldering
L10, L11, L12, L13, L14: 100Z; C_0805
P2: DATA; IDC_08M
R46, R47: 49.9; R_0603
R48, R49, R50, R51: 360; R_0603
R52, R53, R54, R55: 180; R_0603
R56, R57, R58, R59: 52; R_0603
R61, R62, R63, R64: inf; R_0603
R65, R66, R70, R71, R72, R73: 30; R_0603
R67: 470; R_0603
R68: 160; R_0603
R69: 2k; R_0603
RN2: 3k; R_Array_Concave_4x0402
U7, U8: EL5166; SOT-23-6
U9: 25MHz; Crystal_5.0x3.2mm
U10: AD9958; CP-56-1
U11, U12: TPS79318; SOT-23-5
X5, X6: SMA; SMA-NORMAL-MY

Connections:
3.3VA: C54.1, L10.1; also elsewhere on the board
+1V8: C75.1, C78.1, U10.45 (DVDD), U10.55 (DVDD), U11.5 (OUT)
+5VA: L13.2; also elsewhere on the board
-5VA: L14.2; also elsewhere on the board
/generator_AD9958/+5VU: C38.1, C39.1, L13.1, U7.6 (V+), U8.6 (V+)
/generator_AD9958/-5VU: C36.1, C37.1, L14.1, U7.2 (V-), U7.5 (~CE), U8.2 (V-), U8.5 (~CE)
/generator_AD9958/I/O_UPD: P2.8, R73.1
/generator_AD9958/MASTER_RESET: P2.4, R65.2
/generator_AD9958/PWR_DWN_CTL: P2.3, R66.2
/generator_AD9958/SCK: P2.6, R71.1
/generator_AD9958/SDIO_0: P2.5, R70.1
/generator_AD9958/~CS: P2.7, R72.1
Earth: C36.2, C37.2, C38.2, C39.2, C40.2, C41.2, C42.2, C43.2, C44.2, C45.2, C50.2, C51.2, C52.2, C53.2, C54.2, C59.2, C60.2, C61.2, C62.2, C63.2, C65.2, C67.2, C68.2, C69.2, C70.2, C71.2, C72.2, C73.2, C74.2, C75.2, C76.2, C77.2, C78.2, C79.2, C80.2, C91.2, P2.1, P2.2, R50.2, R51.2, R68.2, R69.2, RN2.5 (R4.2), RN2.6 (R3.2), RN2.7 (R2.2), U9.2 (GND), U10.6 (AGND), U10.10 (AGND), U10.12 (AGND), U10.16 (AGND), U10.18 (AGND), U10.20 (AGND), U10.24 (CLK_MODE_SEL), U10.25 (AGND), U10.40 (P0), U10.41 (P1), U10.42 (P2), U10.43 (P3), U10.44 (DGND), U10.56 (DGND), U11.2 (GND), U12.2 (GND), X5.2 (GND), X6.2 (GND); also elsewhere on the board
unnamed: C42.1, C46.2, L2.1, R52.1, R56.1
unnamed: C43.1, C47.2, L3.1, R53.1, R57.1
unnamed: C44.1, C48.2, L4.1, R54.1, R58.1
unnamed: C45.1, C49.2, L5.1, R55.1, R59.1
unnamed: C46.1, C50.1, C55.2, L2.2, L6.1
unnamed: C47.1, C51.1, C56.2, L3.2, L7.1
unnamed: C48.1, C52.1, C57.2, L4.2, L8.1
unnamed: C49.1, C53.1, C58.2, L5.2, L9.1
unnamed: C55.1, C59.1, L6.2, R64.2, U10.13 (CH1_IOUT)
unnamed: C56.1, C60.1, L7.2, R62.2, U10.14 (~CH1_IOUT)
unnamed: C57.1, C61.1, L8.2, R63.1, U10.8 (CH0_IOUT)
unnamed: C58.1, C62.1, L9.2, R61.2, U10.9 (~CH0_IOUT)
unnamed: C63.1, L10.2, U9.1 (EN), U9.4 (VCC)
unnamed: C64.1, U10.22 (~REF_CLK)
unnamed: C64.2, R67.1, R68.1
unnamed: C65.1, U10.23 (REF_CLK)
unnamed: C66.1, U10.27 (LOOP_FILTER)
unnamed: C68.1, L11.1, U10.49 (DVDD_I/O)
unnamed: C73.1, U11.4 (NC/FB)
unnamed: C74.1, U12.4 (NC/FB)
unnamed: C76.1, C79.1, L12.2, U12.5 (OUT)
unnamed: R46.1, R48.2, U7.1
unnamed: R46.2, X5.1
unnamed: R47.1, R49.2, U8.1
unnamed: R47.2, X6.1
unnamed: R48.1, R53.2, U7.4 (-)
unnamed: R49.1, R55.2, U8.4 (-)
unnamed: R50.1, R52.2, U7.3 (+)
unnamed: R51.1, R54.2, U8.3 (+)
unnamed: R65.1, U10.3 (MASTER_RESET)
unnamed: R66.1, U10.4 (PWR_DWN_CTL)
unnamed: R67.2, U9.3 (OUT)
unnamed: R69.1, U10.17 (DAC_RSET)
unnamed: R70.2, U10.50 (SDIO_0)
unnamed: R71.2, U10.48 (SCLK)
unnamed: R72.2, U10.47 (~CS)
unnamed: R73.2, U10.46 (I/O_UPDATE)
unnamed: RN2.2 (R2.1), U10.53 (SDIO_3)
unnamed: RN2.3 (R3.1), U10.52 (SDIO_2)
unnamed: RN2.4 (R4.1), U10.51 (SDIO_1)
VAA: C40.1, C41.1, C66.2, C67.1, C69.1, C70.1, C72.1, L12.1, R56.2, R57.2, R58.2, R59.2, R61.1, R62.1, R63.2, R64.1, U10.5 (AVDD), U10.7 (AVDD), U10.11 (AVDD), U10.15 (AVDD), U10.19 (AVDD), U10.21 (AVDD), U10.26 (AVDD), U10.29 (AVDD), U10.30 (AVDD), U10.31 (AVDD), U10.33 (AVDD), U10.35 (AVDD), U10.36 (AVDD), U10.37 (AVDD), U10.39 (AVDD)

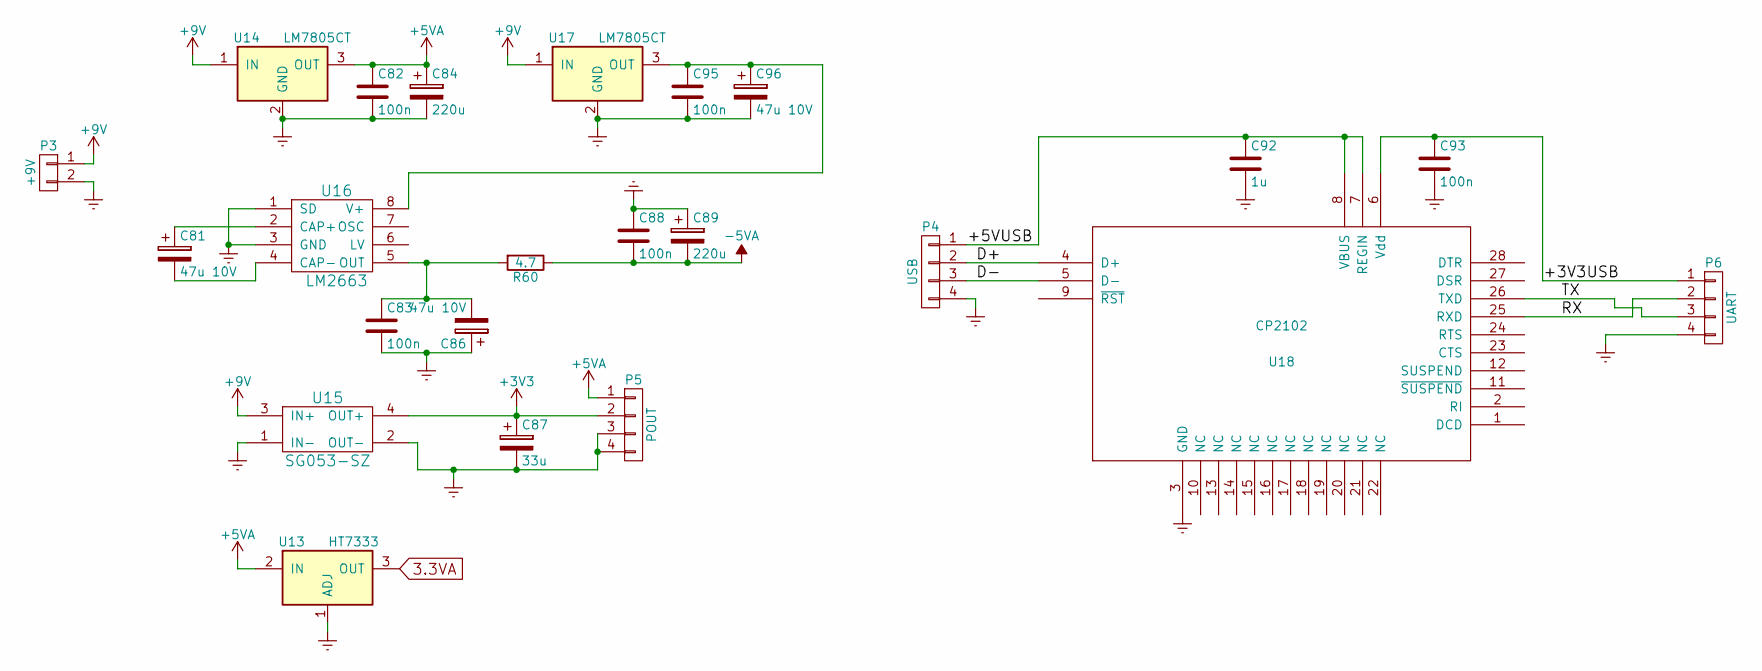
[picture p54: schematic power.sch]

Parts:
C81, C86, C96: 47u 10V; TantalC_SizeB_EIA-3528_HandSoldering
C82, C83, C88, C93, C95: 100n; C_0603
C84, C89: 220u; c_elec_6.3x4.5
C87: 33u; c_elec_6.3x4.5
C92: 1u; C_0603
P3: +9V; Pin_Header_Straight_1x02
P4: USB; Pin_Header_Straight_1x04
P5: POUT; Pin_Header_Straight_1x04
P6: UART; Pin_Header_Straight_1x04
R60: 4.7; R_0603
U13: HT7333; SOT89-3_Housing
U14, U17: LM7805CT; TO-220
U15: SG053-SZ
U16: LM2663; SOIC-8-N
U18: CP2102; MLP-28

Connections:
3.3VA: U13.3 (OUT); also elsewhere on the board
+5VA: C82.1, C84.1, P5.1, U13.2 (IN), U14.3 (OUT); also elsewhere on the board
+9V: P3.1, U14.1 (IN), U15.3 (IN+), U17.1 (IN)
-5VA: C88.2, C89.2, R60.1; also elsewhere on the board
/power/+3V3USB: C93.1, P6.1, U18.6 (Vdd)
/power/+5VUSB: C92.1, P4.1, U18.7 (REGIN), U18.8 (VBUS)
/power/D+: P4.2, U18.4 (D+)
/power/D-: P4.3, U18.5 (D-)
/power/RX: P6.2, U18.25 (RXD)
/power/TX: P6.3, U18.26 (TXD)
Earth: C82.2, C83.2, C84.2, C86.1, C87.2, C88.1, C89.1, C92.2, C93.2, C95.2, C96.2, P3.2, P4.4, P5.3, P5.4, P6.4, U13.1 (ADJ), U14.2 (GND), U15.1 (IN-), U15.2 (OUT-), U16.1 (SD), U16.3 (GND), U17.2 (GND), U18.3 (GND); also elsewhere on the board
unnamed: C81.1, U16.2 (CAP+)
unnamed: C81.2, U16.4 (CAP-)
unnamed: C83.1, C86.2, R60.2, U16.5 (OUT)
unnamed: C95.1, C96.1, U16.8 (V+), U17.3 (OUT)

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
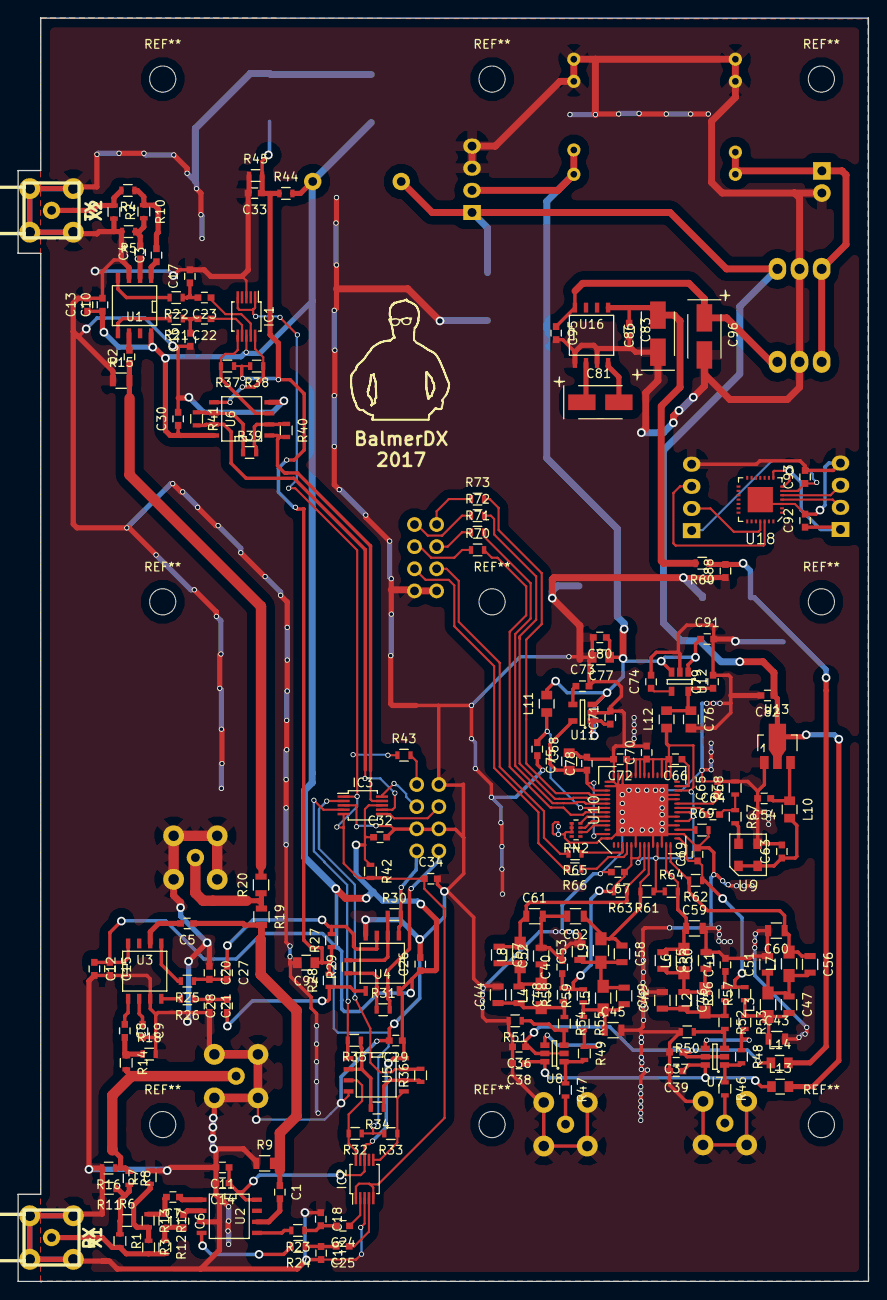
[picture p55: board analog_and_ad9958.kicad_pcb from above]

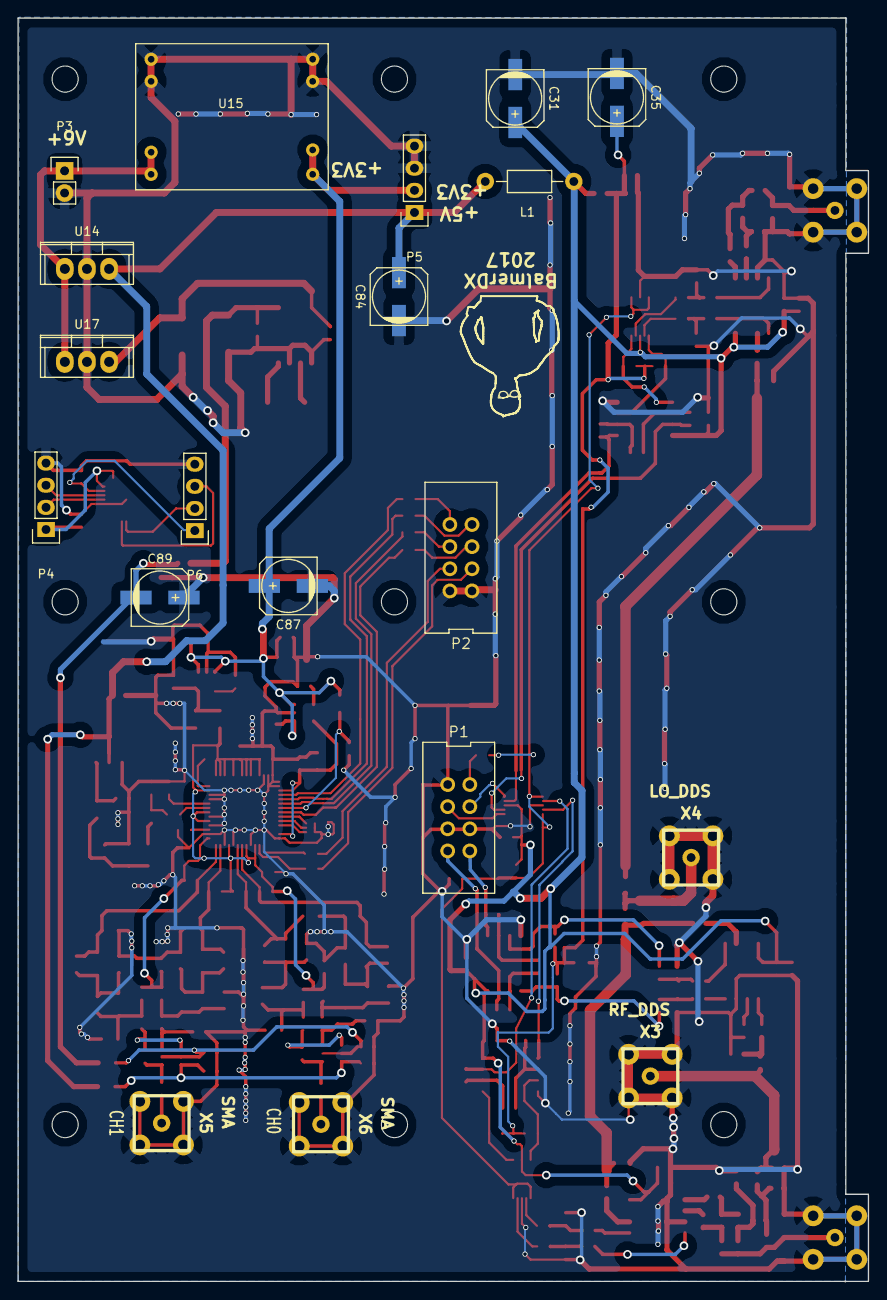
[picture p56: board analog_and_ad9958.kicad_pcb from below]

Board: 4 copper layers, 97.6 x 145.0 mm, 217 parts (20 on the bottom side), 128 nets.

Other parts of the board:
balmer_logo: balmer; balmer_logo
balmer_logo#2: balmer; balmer_logo
