balmerdx/BalmerDX_VNA/(commit log)

2018-08-30 Первоначальный коммит. Вся работа за пару лет.
    [analog_and_ad9958.kicad_pcb, analog_and_ad9958.sch, analog_sa612A.sch, digital_and_adc.kicad_pcb, digital_and_adc.sch, generator_AD9958.sch, periphery.sch, power.sch]
2018-08-30 На одной из плат нестабильно запускался I2C в CS4272. Новый компилятор скомпилировал код быстрее старого.
2018-08-30 - картинки для wiki
2018-08-30 Revert "- картинки для wiki"
    This reverts commit e611a227d7c4d12c0f9eca241eb6663d6c6bd19e.
2018-08-30 - картинки нормального размера
2018-08-31 - schematic pdf
2018-08-31 - схемы в png
2018-08-31 - фотки плат
2018-08-31 - забыли откадрировать
2018-09-02 - device images
2018-09-02 - SOLT calibration
